podwan/biWheeler/hardware/rfBat/log.md

# 2024.4.7

- 烧录点加丝印 

- 购买0805磁珠

- 5V LDO 原理修正 

- 复位按键换成4脚
