podwan/biWheeler/hardware/encoder/doc/AS5600资料/as5600/as5600/MDK-ARM/as5600/as5600.htm

# Static Call Graph for image as5600\as5600.axf

#<CALLGRAPH># ARM Linker, 5060528: Last Updated: Sun Jan 06 20:27:17 2019

### Maximum Stack Usage = 180 bytes + Unknown(Cycles, Untraceable Function Pointers)

### Call chain for Maximum Stack Depth:

main ⇒ SystemClock_Config ⇒ HAL_RCC_ClockConfig ⇒ HAL_RCC_GetSysClockFreq ⇒ __aeabi_uidivmod

### Mutually Recursive functions

- ADC1_IRQHandler ⇒ ADC1_IRQHandler
- HardFault_Handler ⇒ HardFault_Handler

### Function Pointers

- ADC1_IRQHandler from startup_stm32f030x6.o(.text) referenced from startup_stm32f030x6.o(RESET)
- DMA1_Channel1_IRQHandler from startup_stm32f030x6.o(.text) referenced from startup_stm32f030x6.o(RESET)
- DMA1_Channel2_3_IRQHandler from stm32f0xx_it.o(i.DMA1_Channel2_3_IRQHandler) referenced from startup_stm32f030x6.o(RESET)
- DMA1_Channel4_5_IRQHandler from startup_stm32f030x6.o(.text) referenced from startup_stm32f030x6.o(RESET)
- EXTI0_1_IRQHandler from startup_stm32f030x6.o(.text) referenced from startup_stm32f030x6.o(RESET)
- EXTI2_3_IRQHandler from startup_stm32f030x6.o(.text) referenced from startup_stm32f030x6.o(RESET)
- EXTI4_15_IRQHandler from startup_stm32f030x6.o(.text) referenced from startup_stm32f030x6.o(RESET)
- FLASH_IRQHandler from startup_stm32f030x6.o(.text) referenced from startup_stm32f030x6.o(RESET)
- HardFault_Handler from stm32f0xx_it.o(i.HardFault_Handler) referenced from startup_stm32f030x6.o(RESET)
- I2C1_IRQHandler from startup_stm32f030x6.o(.text) referenced from startup_stm32f030x6.o(RESET)
- NMI_Handler from stm32f0xx_it.o(i.NMI_Handler) referenced from startup_stm32f030x6.o(RESET)
- PendSV_Handler from stm32f0xx_it.o(i.PendSV_Handler) referenced from startup_stm32f030x6.o(RESET)
- RCC_IRQHandler from startup_stm32f030x6.o(.text) referenced from startup_stm32f030x6.o(RESET)
- RTC_IRQHandler from startup_stm32f030x6.o(.text) referenced from startup_stm32f030x6.o(RESET)
- Reset_Handler from startup_stm32f030x6.o(.text) referenced from startup_stm32f030x6.o(RESET)
- SPI1_IRQHandler from startup_stm32f030x6.o(.text) referenced from startup_stm32f030x6.o(RESET)
- SVC_Handler from stm32f0xx_it.o(i.SVC_Handler) referenced from startup_stm32f030x6.o(RESET)
- SysTick_Handler from stm32f0xx_it.o(i.SysTick_Handler) referenced from startup_stm32f030x6.o(RESET)
- SystemInit from system_stm32f0xx.o(i.SystemInit) referenced from startup_stm32f030x6.o(.text)
- TIM14_IRQHandler from startup_stm32f030x6.o(.text) referenced from startup_stm32f030x6.o(RESET)
- TIM16_IRQHandler from startup_stm32f030x6.o(.text) referenced from startup_stm32f030x6.o(RESET)
- TIM17_IRQHandler from startup_stm32f030x6.o(.text) referenced from startup_stm32f030x6.o(RESET)
- TIM1_BRK_UP_TRG_COM_IRQHandler from startup_stm32f030x6.o(.text) referenced from startup_stm32f030x6.o(RESET)
- TIM1_CC_IRQHandler from startup_stm32f030x6.o(.text) referenced from startup_stm32f030x6.o(RESET)
- TIM3_IRQHandler from startup_stm32f030x6.o(.text) referenced from startup_stm32f030x6.o(RESET)
- UART_DMAAbortOnError from stm32f0xx_hal_uart.o(i.UART_DMAAbortOnError) referenced from stm32f0xx_hal_uart.o(i.HAL_UART_IRQHandler)
- USART1_IRQHandler from stm32f0xx_it.o(i.USART1_IRQHandler) referenced from startup_stm32f030x6.o(RESET)
- WWDG_IRQHandler from startup_stm32f030x6.o(.text) referenced from startup_stm32f030x6.o(RESET)
- __main from entry.o(.ARM.Collect$$$$00000000) referenced from startup_stm32f030x6.o(.text)
- fputc from main.o(i.fputc) referenced from printfa.o(i.__0printf)
- main from main.o(i.main) referenced from entry9a.o(.ARM.Collect$$$$0000000B)

### Global Symbols

__main (Thumb, 0 bytes, Stack size unknown bytes, entry.o(.ARM.Collect$$$$00000000))
[Address Reference Count : 1]

- startup_stm32f030x6.o(.text)

_main_stk (Thumb, 0 bytes, Stack size unknown bytes, entry2.o(.ARM.Collect$$$$00000001))

_main_scatterload (Thumb, 0 bytes, Stack size unknown bytes, entry5.o(.ARM.Collect$$$$00000004))

[Calls]

- >> __scatterload

__main_after_scatterload (Thumb, 0 bytes, Stack size unknown bytes, entry5.o(.ARM.Collect$$$$00000004))

[Called By]

- >> __scatterload

_main_clock (Thumb, 0 bytes, Stack size unknown bytes, entry7b.o(.ARM.Collect$$$$00000008))

_main_cpp_init (Thumb, 0 bytes, Stack size unknown bytes, entry8b.o(.ARM.Collect$$$$0000000A))

_main_init (Thumb, 0 bytes, Stack size unknown bytes, entry9a.o(.ARM.Collect$$$$0000000B))

__rt_final_cpp (Thumb, 0 bytes, Stack size unknown bytes, entry10a.o(.ARM.Collect$$$$0000000D))

__rt_final_exit (Thumb, 0 bytes, Stack size unknown bytes, entry11a.o(.ARM.Collect$$$$0000000F))

Reset_Handler (Thumb, 8 bytes, Stack size 0 bytes, startup_stm32f030x6.o(.text))
[Address Reference Count : 1]

- startup_stm32f030x6.o(RESET)

ADC1_IRQHandler (Thumb, 0 bytes, Stack size 0 bytes, startup_stm32f030x6.o(.text))

[Calls]

- >> ADC1_IRQHandler

[Called By]

- >> ADC1_IRQHandler

[Address Reference Count : 1]

- startup_stm32f030x6.o(RESET)

DMA1_Channel1_IRQHandler (Thumb, 0 bytes, Stack size 0 bytes, startup_stm32f030x6.o(.text))
[Address Reference Count : 1]

- startup_stm32f030x6.o(RESET)

DMA1_Channel4_5_IRQHandler (Thumb, 0 bytes, Stack size 0 bytes, startup_stm32f030x6.o(.text))
[Address Reference Count : 1]

- startup_stm32f030x6.o(RESET)

EXTI0_1_IRQHandler (Thumb, 0 bytes, Stack size 0 bytes, startup_stm32f030x6.o(.text))
[Address Reference Count : 1]

- startup_stm32f030x6.o(RESET)

EXTI2_3_IRQHandler (Thumb, 0 bytes, Stack size 0 bytes, startup_stm32f030x6.o(.text))
[Address Reference Count : 1]

- startup_stm32f030x6.o(RESET)

EXTI4_15_IRQHandler (Thumb, 0 bytes, Stack size 0 bytes, startup_stm32f030x6.o(.text))
[Address Reference Count : 1]

- startup_stm32f030x6.o(RESET)

FLASH_IRQHandler (Thumb, 0 bytes, Stack size 0 bytes, startup_stm32f030x6.o(.text))
[Address Reference Count : 1]

- startup_stm32f030x6.o(RESET)

I2C1_IRQHandler (Thumb, 0 bytes, Stack size 0 bytes, startup_stm32f030x6.o(.text))
[Address Reference Count : 1]

- startup_stm32f030x6.o(RESET)

RCC_IRQHandler (Thumb, 0 bytes, Stack size 0 bytes, startup_stm32f030x6.o(.text))
[Address Reference Count : 1]

- startup_stm32f030x6.o(RESET)

RTC_IRQHandler (Thumb, 0 bytes, Stack size 0 bytes, startup_stm32f030x6.o(.text))
[Address Reference Count : 1]

- startup_stm32f030x6.o(RESET)

SPI1_IRQHandler (Thumb, 0 bytes, Stack size 0 bytes, startup_stm32f030x6.o(.text))
[Address Reference Count : 1]

- startup_stm32f030x6.o(RESET)

TIM14_IRQHandler (Thumb, 0 bytes, Stack size 0 bytes, startup_stm32f030x6.o(.text))
[Address Reference Count : 1]

- startup_stm32f030x6.o(RESET)

TIM16_IRQHandler (Thumb, 0 bytes, Stack size 0 bytes, startup_stm32f030x6.o(.text))
[Address Reference Count : 1]

- startup_stm32f030x6.o(RESET)

TIM17_IRQHandler (Thumb, 0 bytes, Stack size 0 bytes, startup_stm32f030x6.o(.text))
[Address Reference Count : 1]

- startup_stm32f030x6.o(RESET)

TIM1_BRK_UP_TRG_COM_IRQHandler (Thumb, 0 bytes, Stack size 0 bytes, startup_stm32f030x6.o(.text))
[Address Reference Count : 1]

- startup_stm32f030x6.o(RESET)

TIM1_CC_IRQHandler (Thumb, 0 bytes, Stack size 0 bytes, startup_stm32f030x6.o(.text))
[Address Reference Count : 1]

- startup_stm32f030x6.o(RESET)

TIM3_IRQHandler (Thumb, 0 bytes, Stack size 0 bytes, startup_stm32f030x6.o(.text))
[Address Reference Count : 1]

- startup_stm32f030x6.o(RESET)

WWDG_IRQHandler (Thumb, 0 bytes, Stack size 0 bytes, startup_stm32f030x6.o(.text))
[Address Reference Count : 1]

- startup_stm32f030x6.o(RESET)

__aeabi_uidiv (Thumb, 0 bytes, Stack size 12 bytes, uidiv.o(.text), UNUSED)

__aeabi_uidivmod (Thumb, 44 bytes, Stack size 12 bytes, uidiv.o(.text))

[Stack]

- Max Depth = 12
- Call Chain = __aeabi_uidivmod

[Called By]

- >> DMA_CalcBaseAndBitshift
- >> HAL_InitTick
- >> HAL_RCC_GetSysClockFreq
- >> UART_SetConfig
- >> _printf_core

__aeabi_llsr (Thumb, 34 bytes, Stack size 8 bytes, llushr.o(.text))

[Stack]

- Max Depth = 8
- Call Chain = __aeabi_llsr

[Called By]

- >> __aeabi_uldivmod
- >> _double_epilogue
- >> __aeabi_d2ulz

_ll_ushift_r (Thumb, 0 bytes, Stack size 8 bytes, llushr.o(.text), UNUSED)

__aeabi_memset (Thumb, 14 bytes, Stack size 0 bytes, memseta.o(.text), UNUSED)

[Called By]

- >> _memset$wrapper
- >> __aeabi_memclr

__aeabi_memset4 (Thumb, 0 bytes, Stack size 0 bytes, memseta.o(.text), UNUSED)

__aeabi_memset8 (Thumb, 0 bytes, Stack size 0 bytes, memseta.o(.text), UNUSED)

__aeabi_memclr (Thumb, 4 bytes, Stack size 0 bytes, memseta.o(.text), UNUSED)

[Calls]

- >> __aeabi_memset

__aeabi_memclr4 (Thumb, 0 bytes, Stack size 0 bytes, memseta.o(.text))

[Called By]

- >> HAL_UART_MspInit
- >> SystemClock_Config
- >> MX_GPIO_Init

__aeabi_memclr8 (Thumb, 0 bytes, Stack size 0 bytes, memseta.o(.text), UNUSED)

_memset$wrapper (Thumb, 18 bytes, Stack size 8 bytes, memseta.o(.text), UNUSED)

[Calls]

- >> __aeabi_memset

__aeabi_dmul (Thumb, 202 bytes, Stack size 72 bytes, dmul.o(.text))

[Stack]

- Max Depth = 128
- Call Chain = __aeabi_dmul ⇒ _double_epilogue ⇒ __aeabi_llsr

[Calls]

- >> _double_epilogue

[Called By]

- >> convertRawAngleToDegrees
- >> _fp_digits

__aeabi_i2d (Thumb, 34 bytes, Stack size 16 bytes, dflti.o(.text))

[Stack]

- Max Depth = 72
- Call Chain = __aeabi_i2d ⇒ _double_epilogue ⇒ __aeabi_llsr

[Calls]

- >> _double_epilogue

[Called By]

- >> convertRawAngleToDegrees

__aeabi_f2d (Thumb, 40 bytes, Stack size 0 bytes, f2d.o(.text))

[Called By]

- >> Programe_Run

__aeabi_d2f (Thumb, 56 bytes, Stack size 8 bytes, d2f.o(.text))

[Stack]

- Max Depth = 8
- Call Chain = __aeabi_d2f

[Calls]

- >> _float_round

[Called By]

- >> convertRawAngleToDegrees

__aeabi_uldivmod (Thumb, 96 bytes, Stack size 48 bytes, uldiv.o(.text), UNUSED)

[Calls]

- >> __aeabi_llsr
- >> __aeabi_llsl

[Called By]

- >> _printf_core
- >> _fp_digits

__I$use$fp (Thumb, 0 bytes, Stack size 0 bytes, iusefp.o(.text), UNUSED)

_float_round (Thumb, 16 bytes, Stack size 0 bytes, fepilogue.o(.text))

[Called By]

- >> __aeabi_d2f

_float_epilogue (Thumb, 114 bytes, Stack size 12 bytes, fepilogue.o(.text), UNUSED)

_double_round (Thumb, 26 bytes, Stack size 8 bytes, depilogue.o(.text))

[Stack]

- Max Depth = 8
- Call Chain = _double_round

[Called By]

- >> _double_epilogue
- >> __aeabi_ddiv
- >> __aeabi_dadd

_double_epilogue (Thumb, 164 bytes, Stack size 48 bytes, depilogue.o(.text))

[Stack]

- Max Depth = 56
- Call Chain = _double_epilogue ⇒ __aeabi_llsr

[Calls]

- >> __aeabi_llsr
- >> __aeabi_llsl
- >> __ARM_clz
- >> _double_round

[Called By]

- >> __aeabi_i2d
- >> __aeabi_dmul
- >> __aeabi_dadd

__aeabi_dadd (Thumb, 328 bytes, Stack size 48 bytes, dadd.o(.text), UNUSED)

[Calls]

- >> __aeabi_lasr
- >> __aeabi_llsl
- >> _double_round
- >> _double_epilogue

[Called By]

- >> __aeabi_drsub
- >> __aeabi_dsub
- >> _fp_digits

__aeabi_dsub (Thumb, 12 bytes, Stack size 8 bytes, dadd.o(.text), UNUSED)

[Calls]

- >> __aeabi_dadd

__aeabi_drsub (Thumb, 12 bytes, Stack size 8 bytes, dadd.o(.text), UNUSED)

[Calls]

- >> __aeabi_dadd

__aeabi_ddiv (Thumb, 234 bytes, Stack size 40 bytes, ddiv.o(.text), UNUSED)

[Calls]

- >> _double_round

[Called By]

- >> _fp_digits

__aeabi_d2ulz (Thumb, 54 bytes, Stack size 8 bytes, dfixul.o(.text), UNUSED)

[Calls]

- >> __aeabi_llsr
- >> __aeabi_llsl

[Called By]

- >> _fp_digits

__aeabi_cdrcmple (Thumb, 38 bytes, Stack size 0 bytes, cdrcmple.o(.text), UNUSED)

[Called By]

- >> _fp_digits

__scatterload (Thumb, 28 bytes, Stack size 0 bytes, init.o(.text))

[Calls]

- >> __main_after_scatterload

[Called By]

- >> _main_scatterload

__scatterload_rt2 (Thumb, 0 bytes, Stack size 0 bytes, init.o(.text), UNUSED)

__aeabi_llsl (Thumb, 32 bytes, Stack size 8 bytes, llshl.o(.text))

[Stack]

- Max Depth = 8
- Call Chain = __aeabi_llsl

[Called By]

- >> __aeabi_uldivmod
- >> _double_epilogue
- >> __aeabi_dadd
- >> __aeabi_d2ulz

_ll_shift_l (Thumb, 0 bytes, Stack size 8 bytes, llshl.o(.text), UNUSED)

__aeabi_lasr (Thumb, 38 bytes, Stack size 8 bytes, llsshr.o(.text), UNUSED)

[Called By]

- >> __aeabi_dadd

_ll_sshift_r (Thumb, 0 bytes, Stack size 8 bytes, llsshr.o(.text), UNUSED)

DMA1_Channel2_3_IRQHandler (Thumb, 10 bytes, Stack size 8 bytes, stm32f0xx_it.o(i.DMA1_Channel2_3_IRQHandler))

[Stack]

- Max Depth = 24
- Call Chain = DMA1_Channel2_3_IRQHandler ⇒ HAL_DMA_IRQHandler

[Calls]

- >> HAL_DMA_IRQHandler

[Address Reference Count : 1]

- startup_stm32f030x6.o(RESET)

Error_Handler (Thumb, 2 bytes, Stack size 0 bytes, main.o(i.Error_Handler))

[Called By]

- >> HAL_UART_MspInit

HAL_DMA_Abort_IT (Thumb, 72 bytes, Stack size 16 bytes, stm32f0xx_hal_dma.o(i.HAL_DMA_Abort_IT))

[Stack]

- Max Depth = 16
- Call Chain = HAL_DMA_Abort_IT

[Called By]

- >> HAL_UART_IRQHandler

HAL_DMA_IRQHandler (Thumb, 156 bytes, Stack size 16 bytes, stm32f0xx_hal_dma.o(i.HAL_DMA_IRQHandler))

[Stack]

- Max Depth = 16
- Call Chain = HAL_DMA_IRQHandler

[Called By]

- >> DMA1_Channel2_3_IRQHandler

HAL_DMA_Init (Thumb, 84 bytes, Stack size 16 bytes, stm32f0xx_hal_dma.o(i.HAL_DMA_Init))

[Stack]

- Max Depth = 36
- Call Chain = HAL_DMA_Init ⇒ DMA_CalcBaseAndBitshift ⇒ __aeabi_uidivmod

[Calls]

- >> DMA_CalcBaseAndBitshift

[Called By]

- >> HAL_UART_MspInit

HAL_Delay (Thumb, 28 bytes, Stack size 16 bytes, stm32f0xx_hal.o(i.HAL_Delay))

[Stack]

- Max Depth = 16
- Call Chain = HAL_Delay

[Calls]

- >> HAL_GetTick

[Called By]

- >> main

HAL_GPIO_Init (Thumb, 302 bytes, Stack size 24 bytes, stm32f0xx_hal_gpio.o(i.HAL_GPIO_Init))

[Stack]

- Max Depth = 24
- Call Chain = HAL_GPIO_Init

[Called By]

- >> HAL_UART_MspInit
- >> MX_GPIO_Init

HAL_GPIO_WritePin (Thumb, 12 bytes, Stack size 0 bytes, stm32f0xx_hal_gpio.o(i.HAL_GPIO_WritePin))

[Called By]

- >> MX_GPIO_Init

HAL_GetTick (Thumb, 6 bytes, Stack size 0 bytes, stm32f0xx_hal.o(i.HAL_GetTick))

[Called By]

- >> HAL_UART_Transmit
- >> HAL_RCC_OscConfig
- >> HAL_RCC_ClockConfig
- >> HAL_RCCEx_PeriphCLKConfig
- >> HAL_Delay
- >> UART_WaitOnFlagUntilTimeout

HAL_IncTick (Thumb, 10 bytes, Stack size 0 bytes, stm32f0xx_hal.o(i.HAL_IncTick))

[Called By]

- >> SysTick_Handler

HAL_Init (Thumb, 26 bytes, Stack size 8 bytes, stm32f0xx_hal.o(i.HAL_Init))

[Stack]

- Max Depth = 28
- Call Chain = HAL_Init ⇒ HAL_InitTick ⇒ __aeabi_uidivmod

[Calls]

- >> HAL_MspInit
- >> HAL_InitTick

[Called By]

- >> main

HAL_InitTick (Thumb, 34 bytes, Stack size 8 bytes, stm32f0xx_hal.o(i.HAL_InitTick))

[Stack]

- Max Depth = 20
- Call Chain = HAL_InitTick ⇒ __aeabi_uidivmod

[Calls]

- >> HAL_NVIC_SetPriority
- >> __aeabi_uidivmod
- >> HAL_SYSTICK_Config
- >> HAL_RCC_GetHCLKFreq

[Called By]

- >> HAL_RCC_ClockConfig
- >> HAL_Init

HAL_MspInit (Thumb, 34 bytes, Stack size 8 bytes, stm32f0xx_hal_msp.o(i.HAL_MspInit))

[Stack]

- Max Depth = 8
- Call Chain = HAL_MspInit

[Called By]

- >> HAL_Init

HAL_NVIC_EnableIRQ (Thumb, 14 bytes, Stack size 0 bytes, stm32f0xx_hal_cortex.o(i.HAL_NVIC_EnableIRQ))

[Called By]

- >> HAL_UART_MspInit
- >> main

HAL_NVIC_SetPriority (Thumb, 8 bytes, Stack size 8 bytes, stm32f0xx_hal_cortex.o(i.HAL_NVIC_SetPriority))

[Stack]

- Max Depth = 8
- Call Chain = HAL_NVIC_SetPriority

[Calls]

- >> NVIC_SetPriority

[Called By]

- >> HAL_UART_MspInit
- >> main
- >> HAL_InitTick

HAL_RCCEx_PeriphCLKConfig (Thumb, 218 bytes, Stack size 24 bytes, stm32f0xx_hal_rcc_ex.o(i.HAL_RCCEx_PeriphCLKConfig))

[Stack]

- Max Depth = 24
- Call Chain = HAL_RCCEx_PeriphCLKConfig

[Calls]

- >> HAL_GetTick

[Called By]

- >> SystemClock_Config

HAL_RCC_ClockConfig (Thumb, 280 bytes, Stack size 24 bytes, stm32f0xx_hal_rcc.o(i.HAL_RCC_ClockConfig))

[Stack]

- Max Depth = 76
- Call Chain = HAL_RCC_ClockConfig ⇒ HAL_RCC_GetSysClockFreq ⇒ __aeabi_uidivmod

[Calls]

- >> HAL_InitTick
- >> HAL_RCC_GetSysClockFreq
- >> HAL_GetTick

[Called By]

- >> SystemClock_Config

HAL_RCC_GetHCLKFreq (Thumb, 6 bytes, Stack size 0 bytes, stm32f0xx_hal_rcc.o(i.HAL_RCC_GetHCLKFreq))

[Called By]

- >> HAL_InitTick

HAL_RCC_GetPCLK1Freq (Thumb, 20 bytes, Stack size 0 bytes, stm32f0xx_hal_rcc.o(i.HAL_RCC_GetPCLK1Freq))

[Called By]

- >> UART_SetConfig

HAL_RCC_GetSysClockFreq (Thumb, 76 bytes, Stack size 40 bytes, stm32f0xx_hal_rcc.o(i.HAL_RCC_GetSysClockFreq))

[Stack]

- Max Depth = 52
- Call Chain = HAL_RCC_GetSysClockFreq ⇒ __aeabi_uidivmod

[Calls]

- >> __aeabi_uidivmod

[Called By]

- >> HAL_RCC_ClockConfig
- >> UART_SetConfig

HAL_RCC_OscConfig (Thumb, 840 bytes, Stack size 32 bytes, stm32f0xx_hal_rcc.o(i.HAL_RCC_OscConfig))

[Stack]

- Max Depth = 32
- Call Chain = HAL_RCC_OscConfig

[Calls]

- >> HAL_GetTick

[Called By]

- >> SystemClock_Config

HAL_SYSTICK_Config (Thumb, 38 bytes, Stack size 8 bytes, stm32f0xx_hal_cortex.o(i.HAL_SYSTICK_Config))

[Stack]

- Max Depth = 8
- Call Chain = HAL_SYSTICK_Config

[Calls]

- >> NVIC_SetPriority

[Called By]

- >> HAL_InitTick

HAL_UART_ErrorCallback (Thumb, 2 bytes, Stack size 0 bytes, stm32f0xx_hal_uart.o(i.HAL_UART_ErrorCallback))

[Called By]

- >> UART_DMAAbortOnError
- >> HAL_UART_IRQHandler

HAL_UART_IRQHandler (Thumb, 272 bytes, Stack size 24 bytes, stm32f0xx_hal_uart.o(i.HAL_UART_IRQHandler))

[Stack]

- Max Depth = 40
- Call Chain = HAL_UART_IRQHandler ⇒ HAL_DMA_Abort_IT

[Calls]

- >> UART_EndRxTransfer
- >> HAL_UART_ErrorCallback
- >> HAL_DMA_Abort_IT
- >> UART_Transmit_IT
- >> UART_Receive_IT
- >> UART_EndTransmit_IT

[Called By]

- >> USART1_IRQHandler

HAL_UART_Init (Thumb, 108 bytes, Stack size 16 bytes, stm32f0xx_hal_uart.o(i.HAL_UART_Init))

[Stack]

- Max Depth = 92
- Call Chain = HAL_UART_Init ⇒ HAL_UART_MspInit ⇒ HAL_DMA_Init ⇒ DMA_CalcBaseAndBitshift ⇒ __aeabi_uidivmod

[Calls]

- >> HAL_UART_MspInit
- >> UART_SetConfig
- >> UART_CheckIdleState
- >> UART_AdvFeatureConfig

[Called By]

- >> MX_USART1_UART_Init

HAL_UART_MspInit (Thumb, 146 bytes, Stack size 40 bytes, stm32f0xx_hal_msp.o(i.HAL_UART_MspInit))

[Stack]

- Max Depth = 76
- Call Chain = HAL_UART_MspInit ⇒ HAL_DMA_Init ⇒ DMA_CalcBaseAndBitshift ⇒ __aeabi_uidivmod

[Calls]

- >> HAL_DMA_Init
- >> HAL_NVIC_SetPriority
- >> HAL_NVIC_EnableIRQ
- >> HAL_GPIO_Init
- >> Error_Handler
- >> __aeabi_memclr4

[Called By]

- >> HAL_UART_Init

HAL_UART_Receive_IT (Thumb, 132 bytes, Stack size 16 bytes, stm32f0xx_hal_uart.o(i.HAL_UART_Receive_IT))

[Stack]

- Max Depth = 16
- Call Chain = HAL_UART_Receive_IT

[Called By]

- >> main

HAL_UART_RxCpltCallback (Thumb, 2 bytes, Stack size 0 bytes, stm32f0xx_hal_uart.o(i.HAL_UART_RxCpltCallback))

[Called By]

- >> UART_Receive_IT

HAL_UART_Transmit (Thumb, 200 bytes, Stack size 48 bytes, stm32f0xx_hal_uart.o(i.HAL_UART_Transmit))

[Stack]

- Max Depth = 88
- Call Chain = HAL_UART_Transmit ⇒ UART_WaitOnFlagUntilTimeout

[Calls]

- >> HAL_GetTick
- >> UART_WaitOnFlagUntilTimeout

[Called By]

- >> fputc

HAL_UART_TxCpltCallback (Thumb, 2 bytes, Stack size 0 bytes, stm32f0xx_hal_uart.o(i.HAL_UART_TxCpltCallback))

[Called By]

- >> UART_EndTransmit_IT

HardFault_Handler (Thumb, 2 bytes, Stack size 0 bytes, stm32f0xx_it.o(i.HardFault_Handler))

[Calls]

- >> HardFault_Handler

[Called By]

- >> HardFault_Handler

[Address Reference Count : 1]

- startup_stm32f030x6.o(RESET)

NMI_Handler (Thumb, 2 bytes, Stack size 0 bytes, stm32f0xx_it.o(i.NMI_Handler))
[Address Reference Count : 1]

- startup_stm32f030x6.o(RESET)

PendSV_Handler (Thumb, 2 bytes, Stack size 0 bytes, stm32f0xx_it.o(i.PendSV_Handler))
[Address Reference Count : 1]

- startup_stm32f030x6.o(RESET)

Programe_Run (Thumb, 56 bytes, Stack size 8 bytes, as5600.o(i.Programe_Run))

[Stack]

- Max Depth = 144
- Call Chain = Programe_Run ⇒ convertRawAngleToDegrees ⇒ __aeabi_dmul ⇒ _double_epilogue ⇒ __aeabi_llsr

[Calls]

- >> __aeabi_f2d
- >> getRawAngle
- >> detectMagnet
- >> convertRawAngleToDegrees
- >> __2printf

[Called By]

- >> main

SVC_Handler (Thumb, 2 bytes, Stack size 0 bytes, stm32f0xx_it.o(i.SVC_Handler))
[Address Reference Count : 1]

- startup_stm32f030x6.o(RESET)

Sim_I2C1_ReceiveByte (Thumb, 88 bytes, Stack size 16 bytes, as5600.o(i.Sim_I2C1_ReceiveByte))

[Stack]

- Max Depth = 16
- Call Chain = Sim_I2C1_ReceiveByte

[Calls]

- >> Sim_I2C1_SendNACK

[Called By]

- >> Sim_I2C_Read8

Sim_I2C1_ReceiveByte_WithACK (Thumb, 88 bytes, Stack size 16 bytes, as5600.o(i.Sim_I2C1_ReceiveByte_WithACK))

[Stack]

- Max Depth = 16
- Call Chain = Sim_I2C1_ReceiveByte_WithACK

[Calls]

- >> Sim_I2C1_SendACK

[Called By]

- >> Sim_I2C_Read8

Sim_I2C1_START (Thumb, 78 bytes, Stack size 0 bytes, as5600.o(i.Sim_I2C1_START))

[Called By]

- >> Sim_I2C_Read8

Sim_I2C1_STOP (Thumb, 70 bytes, Stack size 0 bytes, as5600.o(i.Sim_I2C1_STOP))

[Called By]

- >> Sim_I2C_Read8
- >> Sim_I2C1_Wait_Ack

Sim_I2C1_SendACK (Thumb, 76 bytes, Stack size 0 bytes, as5600.o(i.Sim_I2C1_SendACK))

[Called By]

- >> Sim_I2C1_ReceiveByte_WithACK

Sim_I2C1_SendByte (Thumb, 102 bytes, Stack size 20 bytes, as5600.o(i.Sim_I2C1_SendByte))

[Stack]

- Max Depth = 20
- Call Chain = Sim_I2C1_SendByte

[Called By]

- >> Sim_I2C_Read8

Sim_I2C1_SendNACK (Thumb, 76 bytes, Stack size 0 bytes, as5600.o(i.Sim_I2C1_SendNACK))

[Called By]

- >> Sim_I2C1_ReceiveByte

Sim_I2C1_Wait_Ack (Thumb, 100 bytes, Stack size 12 bytes, as5600.o(i.Sim_I2C1_Wait_Ack))

[Stack]

- Max Depth = 12
- Call Chain = Sim_I2C1_Wait_Ack

[Calls]

- >> Sim_I2C1_STOP

[Called By]

- >> Sim_I2C_Read8

Sim_I2C_Read8 (Thumb, 88 bytes, Stack size 20 bytes, as5600.o(i.Sim_I2C_Read8))

[Stack]

- Max Depth = 40
- Call Chain = Sim_I2C_Read8 ⇒ Sim_I2C1_SendByte

[Calls]

- >> Sim_I2C1_Wait_Ack
- >> Sim_I2C1_SendByte
- >> Sim_I2C1_STOP
- >> Sim_I2C1_START
- >> Sim_I2C1_ReceiveByte_WithACK
- >> Sim_I2C1_ReceiveByte

[Called By]

- >> readOneByte

SysTick_Handler (Thumb, 8 bytes, Stack size 8 bytes, stm32f0xx_it.o(i.SysTick_Handler))

[Stack]

- Max Depth = 8
- Call Chain = SysTick_Handler

[Calls]

- >> HAL_IncTick

[Address Reference Count : 1]

- startup_stm32f030x6.o(RESET)

SystemClock_Config (Thumb, 92 bytes, Stack size 96 bytes, main.o(i.SystemClock_Config))

[Stack]

- Max Depth = 172
- Call Chain = SystemClock_Config ⇒ HAL_RCC_ClockConfig ⇒ HAL_RCC_GetSysClockFreq ⇒ __aeabi_uidivmod

[Calls]

- >> HAL_RCC_OscConfig
- >> HAL_RCC_ClockConfig
- >> HAL_RCCEx_PeriphCLKConfig
- >> __aeabi_memclr4

[Called By]

- >> main

SystemInit (Thumb, 78 bytes, Stack size 0 bytes, system_stm32f0xx.o(i.SystemInit))
[Address Reference Count : 1]

- startup_stm32f030x6.o(.text)

UART_AdvFeatureConfig (Thumb, 202 bytes, Stack size 8 bytes, stm32f0xx_hal_uart.o(i.UART_AdvFeatureConfig))

[Stack]

- Max Depth = 8
- Call Chain = UART_AdvFeatureConfig

[Called By]

- >> HAL_UART_Init

UART_CheckIdleState (Thumb, 18 bytes, Stack size 0 bytes, stm32f0xx_hal_uart.o(i.UART_CheckIdleState))

[Called By]

- >> HAL_UART_Init

UART_EndTransmit_IT (Thumb, 26 bytes, Stack size 8 bytes, stm32f0xx_hal_uart.o(i.UART_EndTransmit_IT))

[Stack]

- Max Depth = 8
- Call Chain = UART_EndTransmit_IT

[Calls]

- >> HAL_UART_TxCpltCallback

[Called By]

- >> HAL_UART_IRQHandler

UART_Receive_IT (Thumb, 122 bytes, Stack size 16 bytes, stm32f0xx_hal_uart.o(i.UART_Receive_IT))

[Stack]

- Max Depth = 16
- Call Chain = UART_Receive_IT

[Calls]

- >> HAL_UART_RxCpltCallback

[Called By]

- >> HAL_UART_IRQHandler

UART_SetConfig (Thumb, 258 bytes, Stack size 24 bytes, stm32f0xx_hal_uart.o(i.UART_SetConfig))

[Stack]

- Max Depth = 76
- Call Chain = UART_SetConfig ⇒ HAL_RCC_GetSysClockFreq ⇒ __aeabi_uidivmod

[Calls]

- >> __aeabi_uidivmod
- >> HAL_RCC_GetSysClockFreq
- >> HAL_RCC_GetPCLK1Freq

[Called By]

- >> HAL_UART_Init

UART_Transmit_IT (Thumb, 102 bytes, Stack size 0 bytes, stm32f0xx_hal_uart.o(i.UART_Transmit_IT))

[Called By]

- >> HAL_UART_IRQHandler

UART_WaitOnFlagUntilTimeout (Thumb, 98 bytes, Stack size 40 bytes, stm32f0xx_hal_uart.o(i.UART_WaitOnFlagUntilTimeout))

[Stack]

- Max Depth = 40
- Call Chain = UART_WaitOnFlagUntilTimeout

[Calls]

- >> HAL_GetTick

[Called By]

- >> HAL_UART_Transmit

USART1_IRQHandler (Thumb, 10 bytes, Stack size 8 bytes, stm32f0xx_it.o(i.USART1_IRQHandler))

[Stack]

- Max Depth = 48
- Call Chain = USART1_IRQHandler ⇒ HAL_UART_IRQHandler ⇒ HAL_DMA_Abort_IT

[Calls]

- >> HAL_UART_IRQHandler

[Address Reference Count : 1]

- startup_stm32f030x6.o(RESET)

Uart_RxOvertimeEnable (Thumb, 22 bytes, Stack size 0 bytes, main.o(i.Uart_RxOvertimeEnable))

[Called By]

- >> main

__0printf (Thumb, 24 bytes, Stack size 24 bytes, printfa.o(i.__0printf), UNUSED)

[Calls]

- >> _printf_core

__1printf (Thumb, 0 bytes, Stack size 24 bytes, printfa.o(i.__0printf), UNUSED)

__2printf (Thumb, 0 bytes, Stack size 24 bytes, printfa.o(i.__0printf))

[Stack]

- Max Depth = 24
- Call Chain = __2printf

[Called By]

- >> Programe_Run

__c89printf (Thumb, 0 bytes, Stack size 24 bytes, printfa.o(i.__0printf), UNUSED)

printf (Thumb, 0 bytes, Stack size 24 bytes, printfa.o(i.__0printf), UNUSED)

__ARM_clz (Thumb, 46 bytes, Stack size 0 bytes, depilogue.o(i.__ARM_clz))

[Called By]

- >> _double_epilogue

__scatterload_copy (Thumb, 14 bytes, Stack size unknown bytes, handlers.o(i.__scatterload_copy), UNUSED)

__scatterload_null (Thumb, 2 bytes, Stack size unknown bytes, handlers.o(i.__scatterload_null), UNUSED)

__scatterload_zeroinit (Thumb, 14 bytes, Stack size unknown bytes, handlers.o(i.__scatterload_zeroinit), UNUSED)

convertRawAngleToDegrees (Thumb, 20 bytes, Stack size 8 bytes, as5600.o(i.convertRawAngleToDegrees))

[Stack]

- Max Depth = 136
- Call Chain = convertRawAngleToDegrees ⇒ __aeabi_dmul ⇒ _double_epilogue ⇒ __aeabi_llsr

[Calls]

- >> __aeabi_i2d
- >> __aeabi_dmul
- >> __aeabi_d2f

[Called By]

- >> Programe_Run

detectMagnet (Thumb, 20 bytes, Stack size 8 bytes, as5600.o(i.detectMagnet))

[Stack]

- Max Depth = 56
- Call Chain = detectMagnet ⇒ readOneByte ⇒ Sim_I2C_Read8 ⇒ Sim_I2C1_SendByte

[Calls]

- >> readOneByte

[Called By]

- >> Programe_Run

fputc (Thumb, 18 bytes, Stack size 16 bytes, main.o(i.fputc))

[Stack]

- Max Depth = 104
- Call Chain = fputc ⇒ HAL_UART_Transmit ⇒ UART_WaitOnFlagUntilTimeout

[Calls]

- >> HAL_UART_Transmit

[Address Reference Count : 1]

- printfa.o(i.__0printf)

getRawAngle (Thumb, 14 bytes, Stack size 4 bytes, as5600.o(i.getRawAngle))

[Stack]

- Max Depth = 64
- Call Chain = getRawAngle ⇒ readTwoBytes ⇒ readOneByte ⇒ Sim_I2C_Read8 ⇒ Sim_I2C1_SendByte

[Calls]

- >> readTwoBytes

[Called By]

- >> Programe_Run

main (Thumb, 80 bytes, Stack size 8 bytes, main.o(i.main))

[Stack]

- Max Depth = 180
- Call Chain = main ⇒ SystemClock_Config ⇒ HAL_RCC_ClockConfig ⇒ HAL_RCC_GetSysClockFreq ⇒ __aeabi_uidivmod

[Calls]

- >> HAL_UART_Receive_IT
- >> HAL_NVIC_SetPriority
- >> HAL_NVIC_EnableIRQ
- >> HAL_Init
- >> Uart_RxOvertimeEnable
- >> SystemClock_Config
- >> MX_USART1_UART_Init
- >> MX_GPIO_Init
- >> HAL_Delay
- >> Programe_Run

[Address Reference Count : 1]

- entry9a.o(.ARM.Collect$$$$0000000B)

readOneByte (Thumb, 34 bytes, Stack size 8 bytes, as5600.o(i.readOneByte))

[Stack]

- Max Depth = 48
- Call Chain = readOneByte ⇒ Sim_I2C_Read8 ⇒ Sim_I2C1_SendByte

[Calls]

- >> Sim_I2C_Read8

[Called By]

- >> readTwoBytes
- >> detectMagnet

readTwoBytes (Thumb, 24 bytes, Stack size 12 bytes, as5600.o(i.readTwoBytes))

[Stack]

- Max Depth = 60
- Call Chain = readTwoBytes ⇒ readOneByte ⇒ Sim_I2C_Read8 ⇒ Sim_I2C1_SendByte

[Calls]

- >> readOneByte

[Called By]

- >> getRawAngle

### Local Symbols

MX_GPIO_Init (Thumb, 86 bytes, Stack size 40 bytes, main.o(i.MX_GPIO_Init))

[Stack]

- Max Depth = 64
- Call Chain = MX_GPIO_Init ⇒ HAL_GPIO_Init

[Calls]

- >> HAL_GPIO_WritePin
- >> HAL_GPIO_Init
- >> __aeabi_memclr4

[Called By]

- >> main

MX_USART1_UART_Init (Thumb, 40 bytes, Stack size 8 bytes, main.o(i.MX_USART1_UART_Init))

[Stack]

- Max Depth = 100
- Call Chain = MX_USART1_UART_Init ⇒ HAL_UART_Init ⇒ HAL_UART_MspInit ⇒ HAL_DMA_Init ⇒ DMA_CalcBaseAndBitshift ⇒ __aeabi_uidivmod

[Calls]

- >> HAL_UART_Init

[Called By]

- >> main

UART_DMAAbortOnError (Thumb, 20 bytes, Stack size 8 bytes, stm32f0xx_hal_uart.o(i.UART_DMAAbortOnError))

[Stack]

- Max Depth = 8
- Call Chain = UART_DMAAbortOnError

[Calls]

- >> HAL_UART_ErrorCallback

[Address Reference Count : 1]

- stm32f0xx_hal_uart.o(i.HAL_UART_IRQHandler)

UART_EndRxTransfer (Thumb, 30 bytes, Stack size 0 bytes, stm32f0xx_hal_uart.o(i.UART_EndRxTransfer))

[Called By]

- >> HAL_UART_IRQHandler

DMA_CalcBaseAndBitshift (Thumb, 26 bytes, Stack size 8 bytes, stm32f0xx_hal_dma.o(i.DMA_CalcBaseAndBitshift))

[Stack]

- Max Depth = 20
- Call Chain = DMA_CalcBaseAndBitshift ⇒ __aeabi_uidivmod

[Calls]

- >> __aeabi_uidivmod

[Called By]

- >> HAL_DMA_Init

NVIC_SetPriority (Thumb, 60 bytes, Stack size 0 bytes, stm32f0xx_hal_cortex.o(i.NVIC_SetPriority))

[Called By]

- >> HAL_NVIC_SetPriority
- >> HAL_SYSTICK_Config

_fp_digits (Thumb, 344 bytes, Stack size 64 bytes, printfa.o(i._fp_digits), UNUSED)

[Calls]

- >> __aeabi_dmul
- >> __aeabi_uldivmod
- >> __aeabi_ddiv
- >> __aeabi_dadd
- >> __aeabi_d2ulz
- >> __aeabi_cdrcmple

[Called By]

- >> _printf_core

_printf_core (Thumb, 1754 bytes, Stack size 128 bytes, printfa.o(i._printf_core), UNUSED)

[Calls]

- >> __aeabi_uidivmod
- >> __aeabi_uldivmod
- >> _printf_pre_padding
- >> _printf_post_padding
- >> _fp_digits

[Called By]

- >> __0printf

_printf_post_padding (Thumb, 32 bytes, Stack size 24 bytes, printfa.o(i._printf_post_padding), UNUSED)

[Called By]

- >> _printf_core

_printf_pre_padding (Thumb, 44 bytes, Stack size 40 bytes, printfa.o(i._printf_pre_padding), UNUSED)

[Called By]

- >> _printf_core

### Undefined Global Symbols
