podwan/biWheeler/reference/SimpleFOCMini-main/BOM_simplefocmini_2024-04-26.csv

ID | Name | Designator | Footprint | Quantity | Manufacturer Part | Manufacturer | Supplier | Supplier Part | Price
1 | 19-213/Y2C-CQ2R2L/3T(CY) | LED1 | LED0603-R-RD | 1 | 19-213/Y2C-CQ2R2L/3T(CY) | EVERLIGHT | LCSC | C72038 | 0.019
2 | 1kΩ | R5 | R0603 | 1 | 0603WAF4701T5E | UniOhm | LCSC | C23162 | 0.001
3 | 100uF | C3 | CAP-SMD_BD6.3-L6.6-W6.6-FD | 1 | VT1V101M-CRE77 | Vertical Technology | LCSC | C294520 | 0.032
4 | 10kΩ | R1,R2,R3,R4 | R0603 | 4 | 0603WAF4701T5E | UniOhm | LCSC | C23162 | 0.001
5 | 100nF | C1,C2 | C0603 | 2 | CL10B104KB8NNNC | SAMSUNG | LCSC | C1591 | 0.002
6 | 470nF | C4 | C0603 | 1 | CC0603ZRY5V6BB474 | YAGEO | LCSC | C327269 | 0.008
7 | DRV8313PWPR | U1 | HTSSOP-28_L9.8-W4.5-P0.65-LS6.6-BL-EP | 1 | DRV8313PWPR | Texas Instruments | LCSC | C92482 | 2.189
