podwan/biWheeler/reference/Micro-Wheeled_leg-Robot-master/1.RobotModel/Parts-Purchased/BOM.xlsx

Part Name | Recommended Purchase Link | Specifications | Quantity
Joint Actuator | https://item.taobao.com/item.htm?priceTId=2147818c17214662551577531edc58&id=624005504026&ns=1&abbucket=16 | 黑色 STS3032/360° | 2
Wheel Motor | https://item.taobao.com/item.htm?spm=a1z09.2.0.0.6f8c2e8daIyqdB&id=556445606114&_u=k2st8hc2dcef | 零售 | 2
Magnet | https://item.taobao.com/item.htm?id=677927264803&_u=q2st8hc2ca1c&sku_properties=-3:-5 | 直径4mm,厚度1mm | 2
Battery | https://item.taobao.com/item.htm?id=527326501663&_u=k2st8hc287ca&sku_properties=31309:32595472760 | 1100mah | 1
Charger | https://item.taobao.com/item.htm?id=728228890176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 | 平衡锂电充电器 | 1
GB Screws | https://detail.tmall.com/item.htm?id=529656697168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 | M2*4 M2*6 M2.5*5 M3*6 | 20 of each.
GB Nuts | https://detail.tmall.com/item.htm?id=39178267251&rn=b5d916a495226c131bbab29d02221680&abbucket=12 | M2 | 2
Other Screws | https://item.taobao.com/item.htm?spm=a1z09.2.0.0.6f8c2e8daIyqdB&id=538025764032&_u=k2st8hc217d7 | M2.3-0.4*15 | 2
Column_3mm | https://item.taobao.com/item.htm?spm=a1z09.2.0.0.6f8c2e8daIyqdB&id=647328388853&_u=k2st8hc22a77 | M2 x 长3 x 宽3 （贯通牙） | 4
M2x6_BigHead | https://detail.tmall.com/item.htm?id=722946822369&spm=a1z09.2.0.0.6f8c2e8daIyqdB&_u=k2st8hc21ee3 | M2*6 | 4
bearing3-6-2 | https://detail.tmall.com/item.htm?id=611796709407&spm=a1z09.2.0.0.6f8c2e8daIyqdB&_u=k2st8hc2e6c7 | 3*6*2 | 4 | s
bearing4-7-2.5 | https://detail.tmall.com/item.htm?id=611796709407&_u=k2st8hc2e6c7&skuId=4777422306653 | 4*7*2.5 | 4
Pin4-12 | https://detail.tmall.com/item.htm?id=718672136863&spm=a1z09.2.0.0.6f8c2e8daIyqdB&_u=k2st8hc2ae2e | 4X12 | 2
Tire | https://item.taobao.com/item.htm?spm=a1z09.2.0.0.6f8c2e8daIyqdB&id=669383925819&_u=k2st8hc26fde | 直径25宽10mm黑色 | 2
Column_1 | https://detail.tmall.com/item.htm?priceTId=2147804217214673637194390e8199&id=631585716430&xxc=ad_ztc | M2*25+3 | 2
Column_2 | https://detail.tmall.com/item.htm?id=618581380263&spm=a1z09.2.0.0.6f8c2e8daIyqdB&_u=k2st8hc22f44 | M2*8-D3.5MM | 4
Column_3 | https://detail.tmall.com/item.htm?id=19634185206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 | M2*8+3 | 3
