podwan/biWheeler/reference/Micro-Wheeled_leg-Robot-master/2.Hardware/2.EncoderPCB/BOM_PCB_Encoder.csv

ID | Name | Designator | Footprint | Quantity | Manufacturer Part | Manufacturer | Supplier | Supplier Part | Price
1 | GH1.25_4P | J2 | GH1.25_4P_卧贴 | 1 |  | Changjiang Connectors | LCSC | CC225131
2 | 100nf | C1 | C0603 | 1
3 | 1uf | C2 | C0603 | 1
4 | 4.7K | R1,R2 | R0603 | 2
5 | AS5600-ASOM | U1 | SOIC-8_L5.0-W4.0-P1.27-LS6.0-BL | 1 | AS5600-ASOM | Ams | LCSC | C79815 | 8.32
