podwan/biWheeler/reference/Micro-Wheeled_leg-Robot-master/2.Hardware/3.IMUPCB/BOM_PCB_IMU.csv

ID | Name | Designator | Footprint | Quantity | Manufacturer Part | Manufacturer | Supplier | Supplier Part | Price
1 | MPU6050 | P2 | MPU6050 | 1
2 | GH1.25_4P | J2,J1 | GH1.25_4P_卧贴 | 2 |  | Changjiang Connectors | LCSC | CC225131
