podwan/biWheeler/reference/BOM/StackForce双足轮BOM.xlsx

StackForce 双足轮机器人BOM
电子配件
商品简称 | 数量 | 单位 | 规格 | 备注 | 型号
StackForce主控板 | 1 | 块 | StackForce | 购买链接 (https://item.taobao.com/item.htm?spm=a1z10.1-c.w137712-25161502000.3.64eb1bc5SgOITv&id=760739215808)
StackForce 5A小功率驱动板 | 1 | 块 | StackForce | 购买链接 (https://item.taobao.com/item.htm?spm=a1z10.1-c.w137712-25161502000.8.64eb1bc5SgOITv&id=760899823703)
StackForce 舵机板 | 1 | 块 | StackForce | 购买链接 (https://item.taobao.com/item.htm?spm=a1z10.1-c.w137712-25161502000.5.64eb1bc5SgOITv&id=760685702879)
磁编码器 | 2 | 块 | StackForce | 购买链接 (https://item.taobao.com/item.htm?spm=a1z10.1-c.w4004-25161773008.8.64eb1bc5SgOITv&id=760692990504) | MT6701
电机 | 2 | 个 |  |  | 2208
舵机 | 4 | 个 |  |  | DS041MG
遥控器 | 1 | 个 |  |  | MC6C-MINI
接收器 | 1 | 个 |  |  | MC7RBv2
电池 | 1 | 个 | 厚19，宽34，长42 |  | 12V聚合物电池
端头 | 2 | 个 |  | 电机端头 | MR30-U型
编码器线 | 2 | 组 |  | 编码器用 | SH1.0-5P
杜邦线 | 1 | 组 |  | 接收机用 | 3P（母对母）
材料配件
商品简称 | 数量 | 单位 | 规格 | 备注 | 型号
防松螺母 | 4 | 颗 | M3 |  | GB889.1-86
螺母 | 4 | 颗 | M3 |  | DIN934
尼龙柱 | 4 | 根 | 5*3.2*9 |  | ABS
垫片 | 4 | 片 | M3 |  | 304国标
磁铁 | 2 | 颗 | 6*2.5 |  | 径向磁铁
圆头螺丝 | 24 | 颗 | M2*4 |  | GB/T845
圆头螺丝 | 12 | 颗 | M2*10 |  | GB/T845
圆头螺丝 | 4 | 颗 | M3*6 |  | GB/T845
圆头螺丝 | 4 | 颗 | M3*8 |  | GB/T845
圆头螺丝 | 4 | 颗 | M3*16 |  | GB/T845
圆头螺丝 | 4 | 颗 | M4*16 |  | GB/T845
自攻螺丝 | 16 | 颗 | M2*6 |  | GB/T845
平头螺丝 | 22 | 颗 | M2*6 |  | 304国标
平头螺丝 | 16 | 颗 | M3*6 |  | 304国标
螺柱 | 4 | 颗 | M3*7+4 |  | 铜国标/GB
轴承 | 4 | 块 | 外27，内20，厚4 |  | 6704ZZ
轴承 | 6 | 块 | 外18，内12，厚4 |  | 6701ZZ
结构件
商品简称 | 数量 |  |  | 单位
3D打印件 | 25 |  |  | 件
6030-6085轮胎 | 2 |  |  | 个
