podwan/biWheeler/reference/Micro-Wheeled_leg-Robot-master/2.Hardware/4.ServoDebugPCB/BOM_ServoDebug.csv

ID | Name | Designator | Footprint | Quantity | Manufacturer Part | Manufacturer | Supplier | Supplier Part | Price
1 | HDR-F-2.54_2x4 | H1 | HDR-F-2.54_2X4 | 1 |  |  | LCSC | C239344 | 1.0759
2 | 0.1uF | C1,C2 | C0805 | 2 | CC0805KRX7R9BB104 | YAGEO | LCSC | C49678 | 0.0276
3 | WJ126V-5.0-2P | P3 | CONN-TH_WJ126V-5.0-2P | 1 | WJ126V-5.0-2P | ReliaPro | LCSC | C8404 | 0.4358
4 | SS8550 | Q1 | SOT-23_L2.9-W1.3-P0.95-LS2.4-BR | 1 | SS8550 | Slkor(SLKORMICRO Elec.) | LCSC | C444726 | 0.0637
5 | 10k | R1,R2,R3,R4 | R0805 | 4 | 0805W8F1002T5E | UniOhm | LCSC | C17414 | 0.0109
6 | 10k | R5 | R0805 | 1 | 0805W8F2002T5E | UniOhm | LCSC | C4328 | 0.0109
7 | SN74LVC1G126DBVR | U2 | SOT-23-5_L3.0-W1.7-P0.95-LS2.8-BR | 1 | SN74LVC1G125DBVR | TI | LCSC | C23654 | 0.4221
8 | SN74LVC1G125DBVR | U3 | SOT-23-5_L3.0-W1.7-P0.95-LS2.8-BR | 1 | SN74LVC1G125DBVR | TI | LCSC | C23654 | 0.4221
9 | 5264-3A | H2 | 5264-3A | 1 |  |  | LCSC | C146133 | 0.0866
