podwan/biWheeler/hardware/encoder/encoder_edge-Sketch.dxf

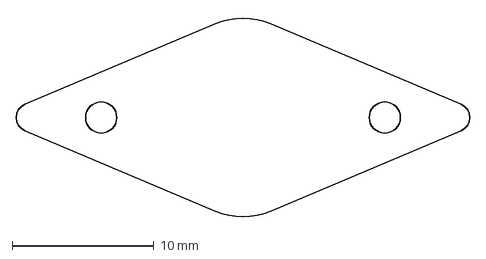
[picture p5: CAD file, 2024-07-28]
hardware/encoder/encoder_edge-Sketch.dxf
32.0 x 14.3 mm
