podwan/biWheeler/hardware/rfBat/bat_rf.step

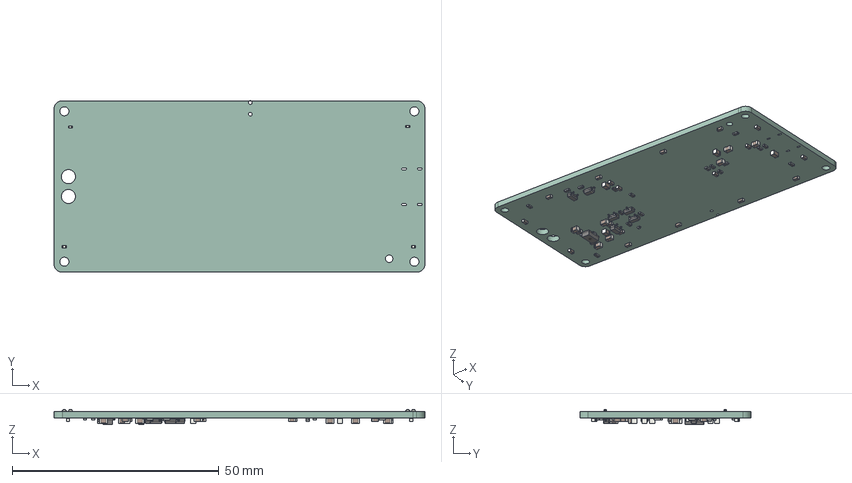
[picture p6: CAD file, 2024-07-28]
hardware/rfBat/bat_rf.step
89.8 x 41.5 x 3.75 mm
LED_0402_1005Metric x 5
CQ assembly
C_0603_1608Metric x 20
C_0805_2012Metric x 11
R_0603_1608Metric x 17
SOT_23 x 4
SOT_23_5
D_SOD_123
bat_rf_PCB
