podwan/biWheeler/hardware/rfBat/model/USB4515-GF-A--3DModel-STEP-269445.STEP

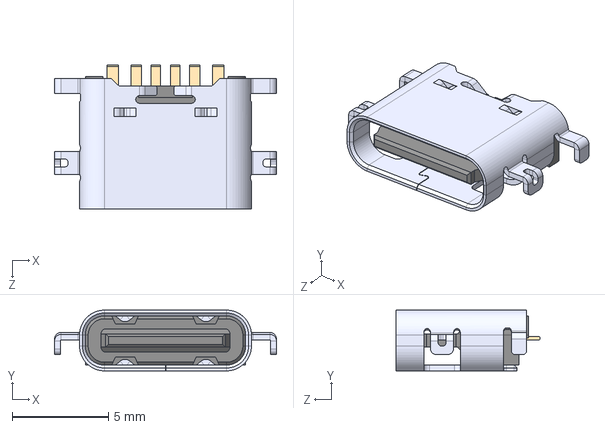
[picture p7: CAD file, 2024-07-28]
hardware/rfBat/model/USB4515-GF-A--3DModel-STEP-269445.STEP
11.5 x 3.16 x 7.50 mm
