podwan/biWheeler/mechanic/模型/后大臂X1.stl

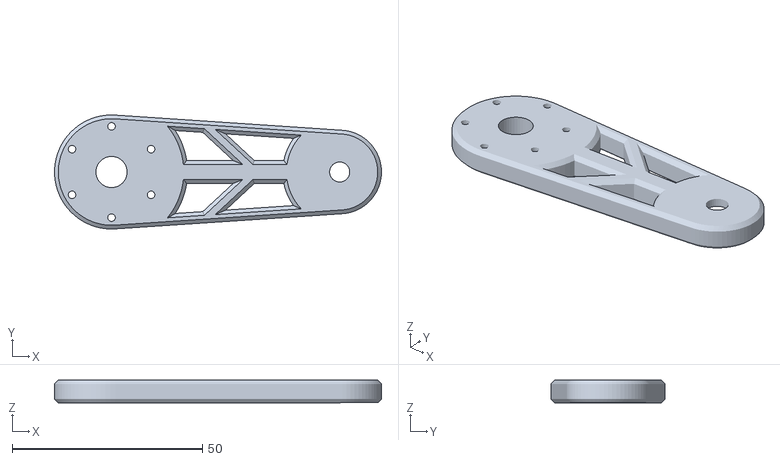
[picture p8: CAD file, 2024-07-28]
mechanic/模型/后大臂X1.stl
86.0 x 30.0 x 6.00
