podwan/biWheeler/reference/Micro-Wheeled_leg-Robot-master/1.RobotModel/Parts-Manufactured/1.3DPrint/Calf x1.stl

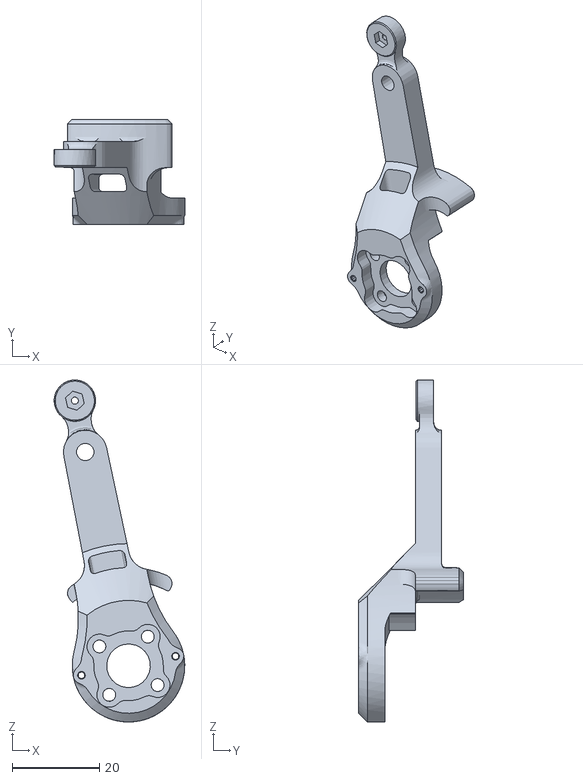
[picture p9: CAD file, 2024-07-28]
reference/Micro-Wheeled_leg-Robot-master/1.RobotModel/Parts-Manufactured/1.3DPrint/Calf x1.stl
29.9 x 24.0 x 78.4
