podwan/biWheeler/reference/Micro-Wheeled_leg-Robot-master/1.RobotModel/Parts-Manufactured/2.CNC/BodyBase-Steel.stp

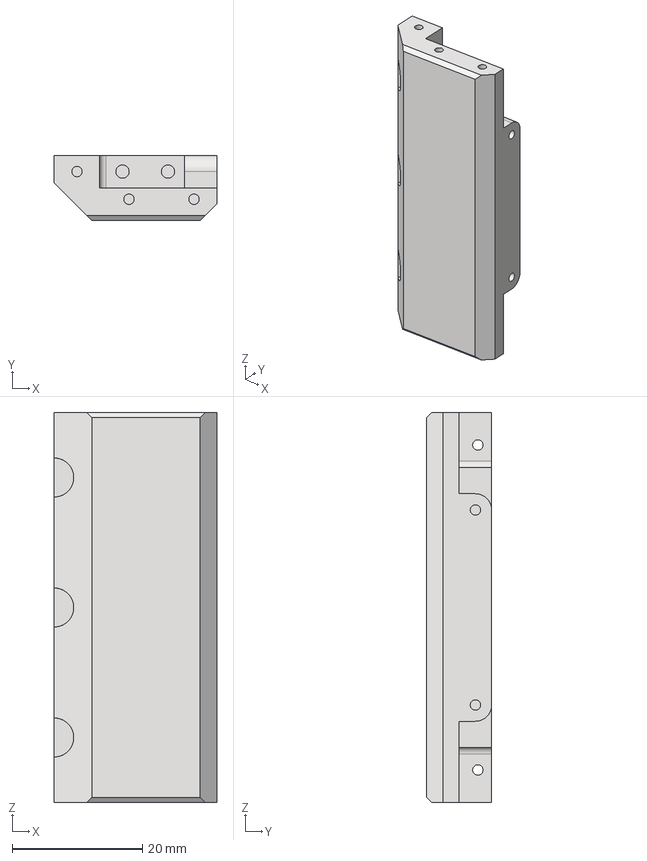
[picture p10: CAD file, 2024-07-28]
reference/Micro-Wheeled_leg-Robot-master/1.RobotModel/Parts-Manufactured/2.CNC/BodyBase-Steel.stp
25.0 x 10.1 x 60.0 mm
