podwan/biWheeler/reference/SimpleFOCMini-main/3D model/OBJ_simplefocmini.obj

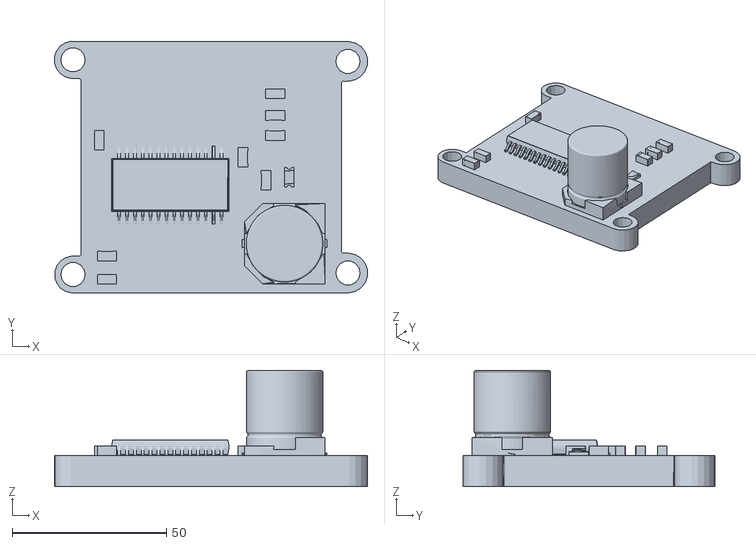
[picture p11: CAD file, 2024-07-28]
reference/SimpleFOCMini-main/3D model/OBJ_simplefocmini.obj
101.3 x 81.4 x 37.6
