podwan/biWheeler/hardware/controller/3d/TC-1102N-C-AS-B.stp

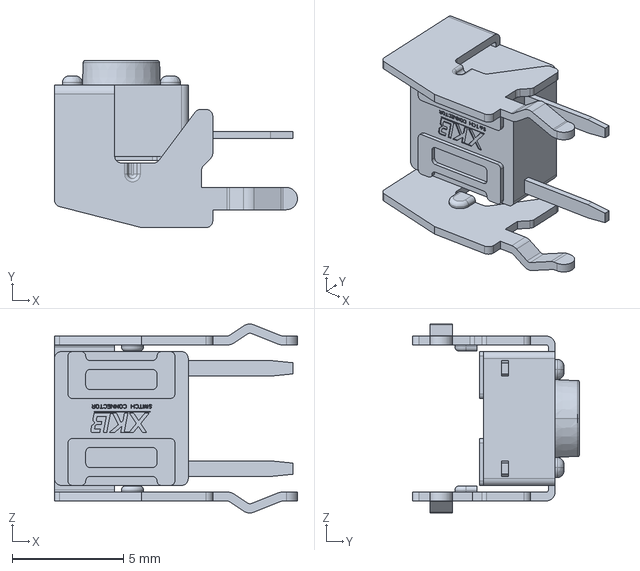
[picture p12: CAD file, 2024-07-28]
hardware/controller/3d/TC-1102N-C-AS-B.stp
10.9 x 7.50 x 8.48 mm
