podwan/biWheeler/hardware/encoder/encoder_edge.dxf

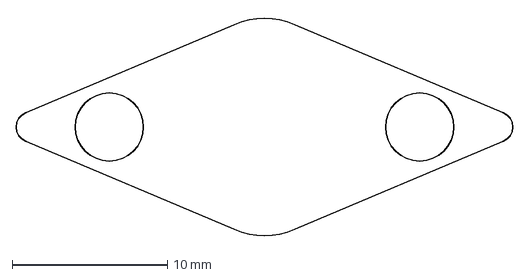
[picture p13: CAD file, 2024-07-28]
hardware/encoder/encoder_edge.dxf
32.0 x 14.3 mm
