podwan/biWheeler/mechanic/模型/舵机架X2.stl

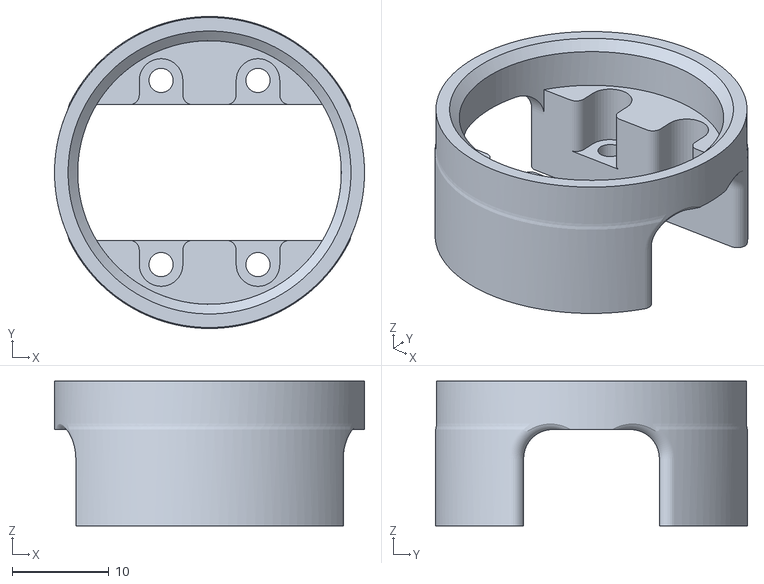
[picture p14: CAD file, 2024-07-28]
mechanic/模型/舵机架X2.stl
32.0 x 32.2 x 14.9
