podwan/biWheeler/reference/Micro-Wheeled_leg-Robot-master/1.RobotModel/Parts-Manufactured/1.3DPrint/ThighCover_MIR x1.stl

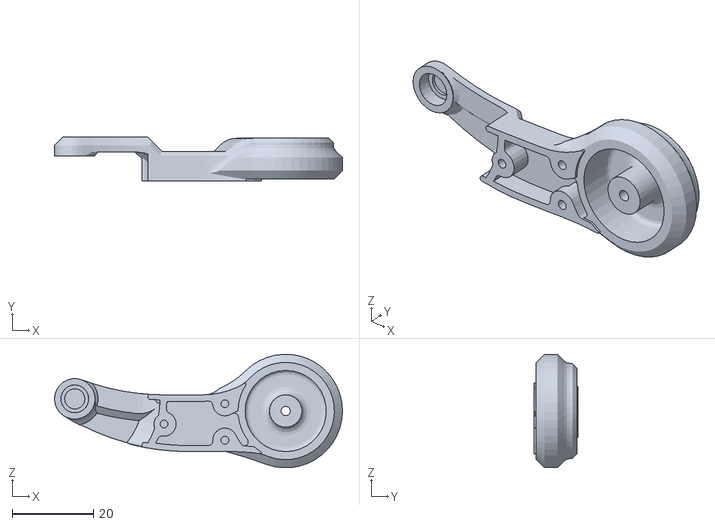
[picture p15: CAD file, 2024-07-28]
reference/Micro-Wheeled_leg-Robot-master/1.RobotModel/Parts-Manufactured/1.3DPrint/ThighCover_MIR x1.stl
71.0 x 10.8 x 28.0
