podwan/biWheeler/reference/Micro-Wheeled_leg-Robot-master/1.RobotModel/Parts-Manufactured/2.CNC/MotorBase-Aluminum6061.stp

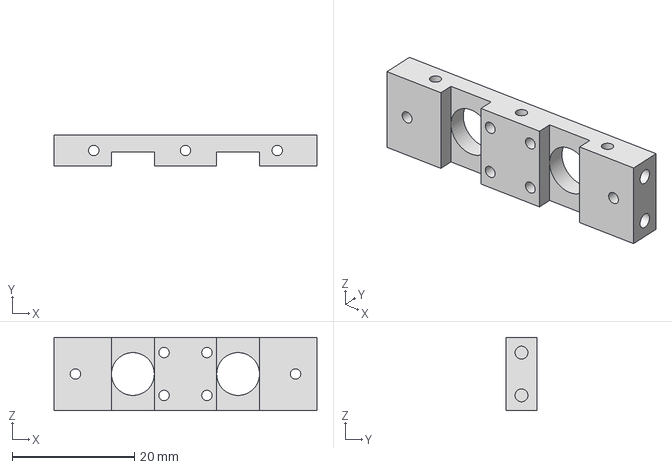
[picture p16: CAD file, 2024-07-28]
reference/Micro-Wheeled_leg-Robot-master/1.RobotModel/Parts-Manufactured/2.CNC/MotorBase-Aluminum6061.stp
43.0 x 5.00 x 12.0 mm
