podwan/biWheeler/reference/Micro-Wheeled_leg-Robot-master/1.RobotModel/Parts-Manufactured/1.3DPrint/Thigh x1.stl

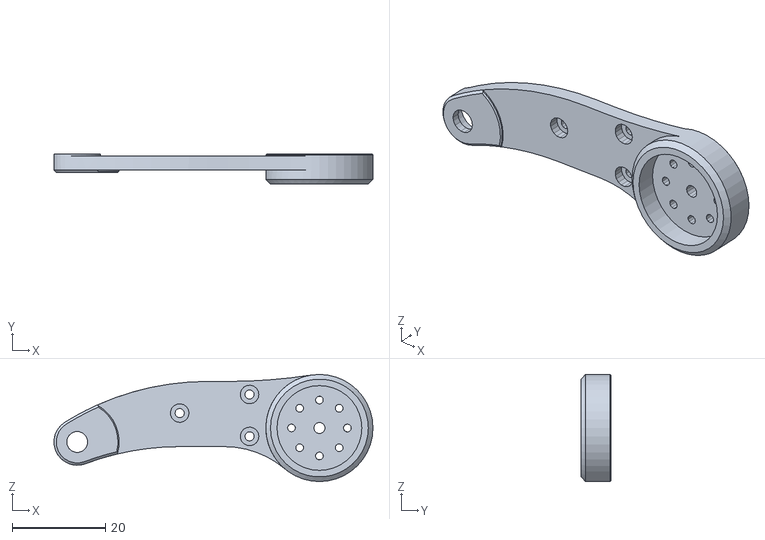
[picture p17: CAD file, 2024-07-28]
reference/Micro-Wheeled_leg-Robot-master/1.RobotModel/Parts-Manufactured/1.3DPrint/Thigh x1.stl
68.5 x 6.50 x 23.0
