podwan/biWheeler/mechanic/模型/轮毂X2.stl

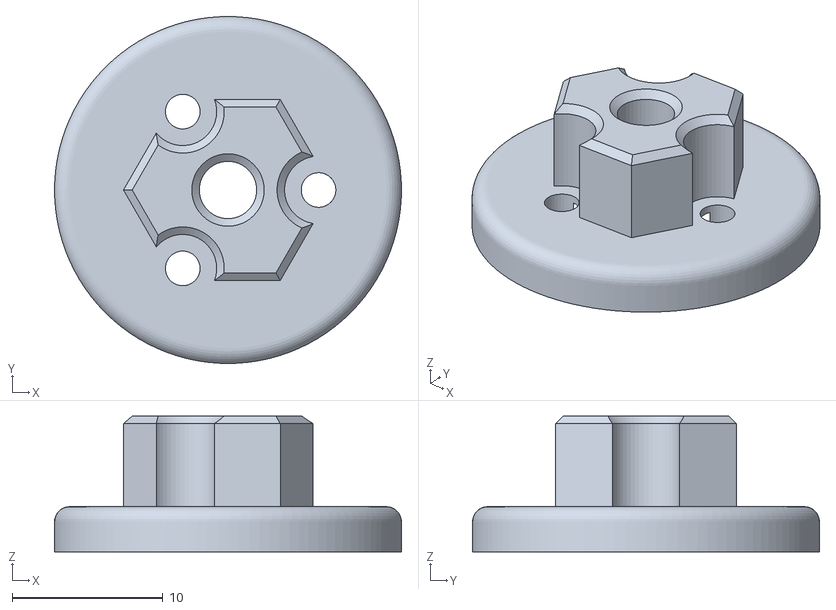
[picture p18: CAD file, 2024-07-28]
mechanic/模型/轮毂X2.stl
23.0 x 23.0 x 9.00
