podwan/biWheeler/reference/Micro-Wheeled_leg-Robot-master/1.RobotModel/Parts-Manufactured/1.3DPrint/ColumnCover x2.stl

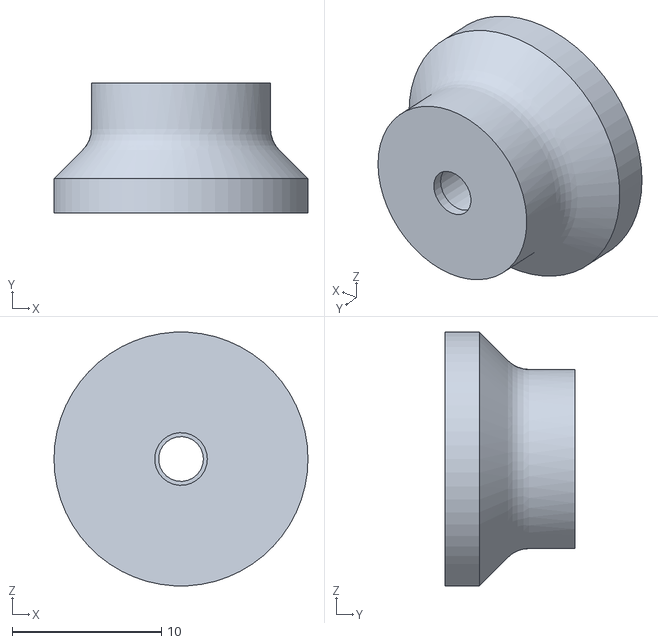
[picture p19: CAD file, 2024-07-28]
reference/Micro-Wheeled_leg-Robot-master/1.RobotModel/Parts-Manufactured/1.3DPrint/ColumnCover x2.stl
17.0 x 8.70 x 17.0
