podwan/biWheeler/mechanic/模型/轮固定X2.stl

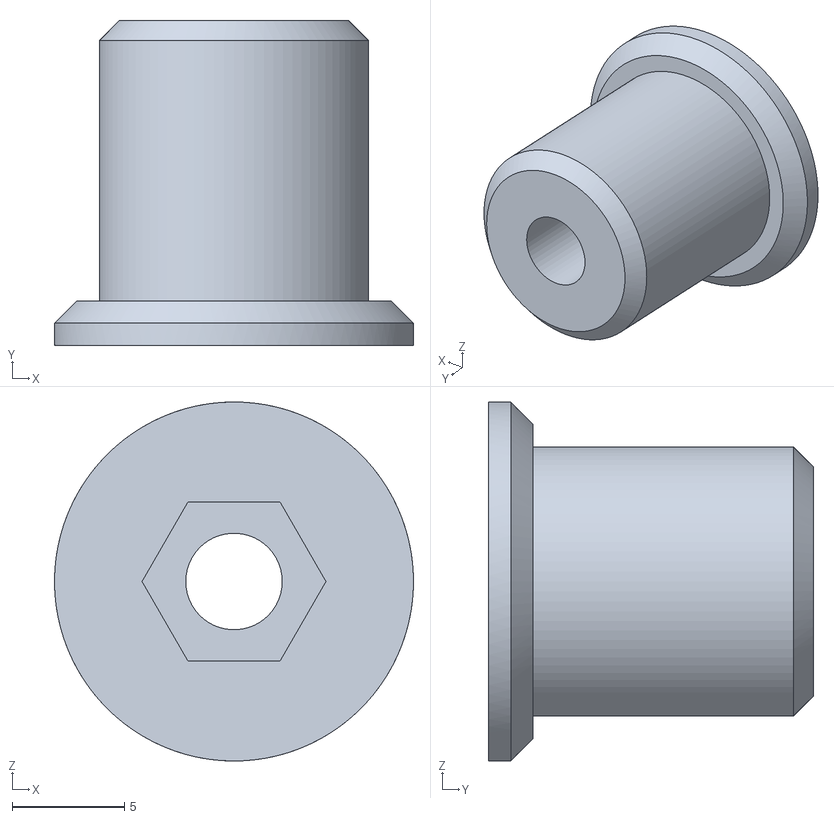
[picture p20: CAD file, 2024-07-28]
mechanic/模型/轮固定X2.stl
16.0 x 14.5 x 16.0
