podwan/biWheeler/mechanic/模型/舵机固定X1.stl

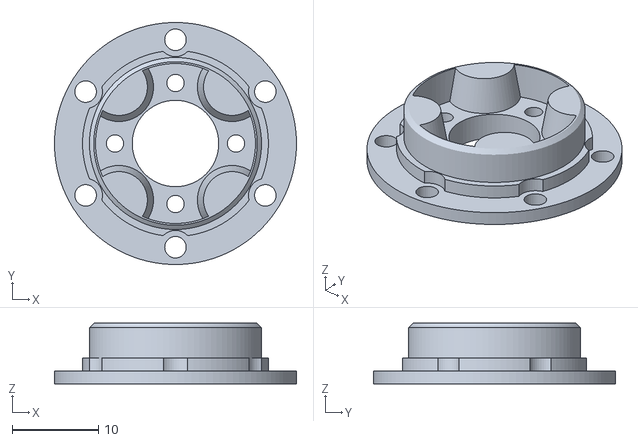
[picture p21: CAD file, 2024-07-28]
mechanic/模型/舵机固定X1.stl
28.0 x 28.0 x 7.00
