podwan/biWheeler/reference/Micro-Wheeled_leg-Robot-master/1.RobotModel/Parts-Manufactured/1.3DPrint/Hub x2.stl

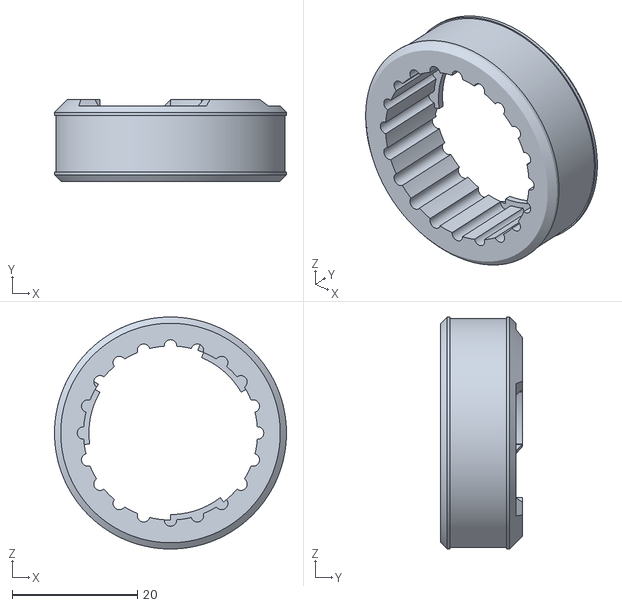
[picture p22: CAD file, 2024-07-28]
reference/Micro-Wheeled_leg-Robot-master/1.RobotModel/Parts-Manufactured/1.3DPrint/Hub x2.stl
37.0 x 13.0 x 37.0
