podwan/biWheeler/mechanic/模型/前小臂X1.stl

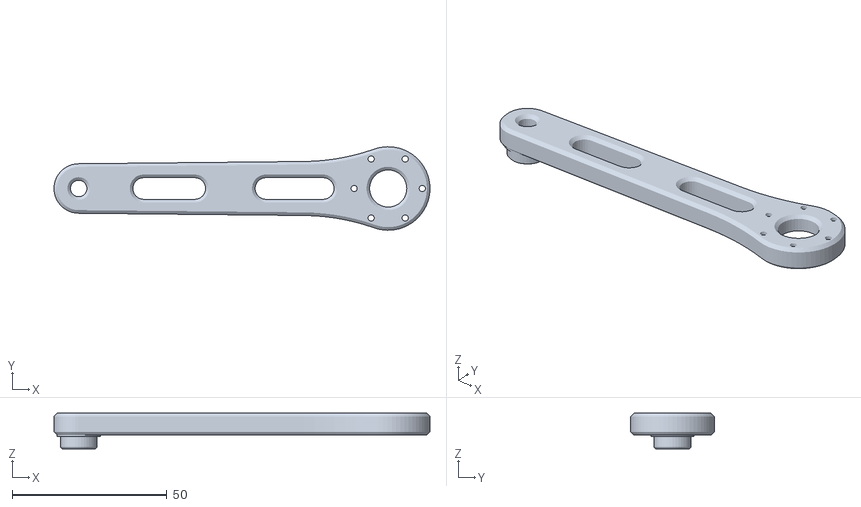
[picture p23: CAD file, 2024-07-28]
mechanic/模型/前小臂X1.stl
121.5 x 27.0 x 11.5
