podwan/biWheeler/mechanic/模型/电机固定X2.stl

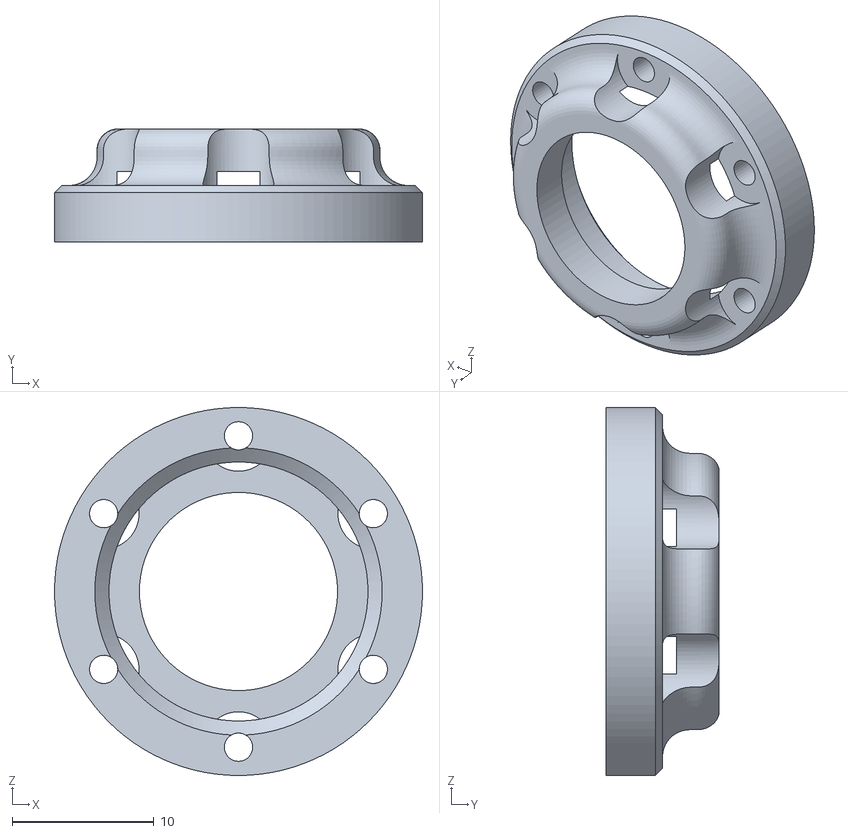
[picture p24: CAD file, 2024-07-28]
mechanic/模型/电机固定X2.stl
26.0 x 8.00 x 26.0
