podwan/biWheeler/mechanic/模型/后小臂X1.stl

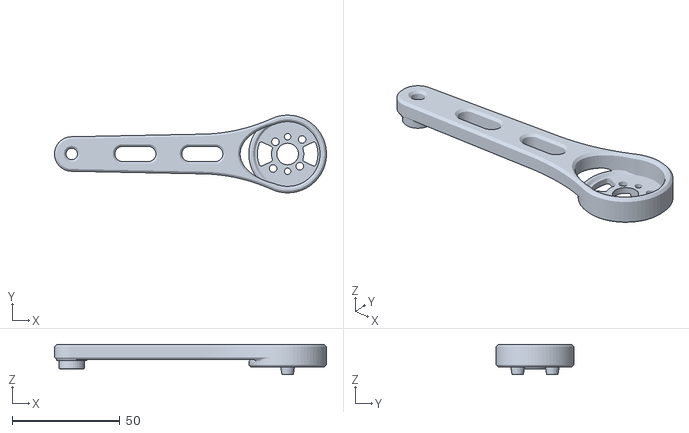
[picture p25: CAD file, 2024-07-28]
mechanic/模型/后小臂X1.stl
126.0 x 36.0 x 14.0
