podwan/biWheeler/mechanic/模型/框架.stl

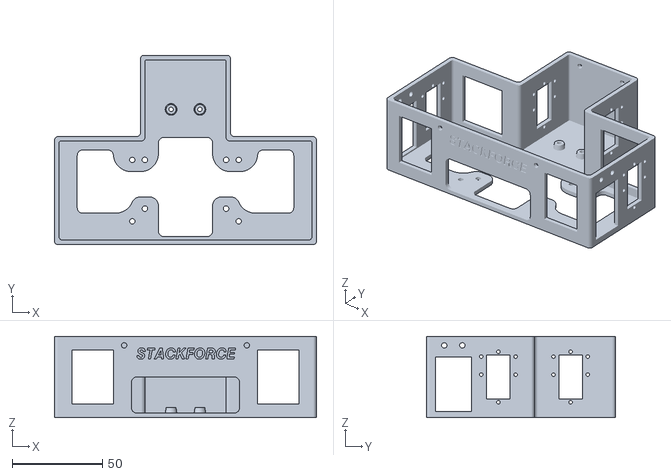
[picture p26: CAD file, 2024-07-28]
mechanic/模型/框架.stl
145.2 x 105.0 x 45.0
