podwan/biWheeler/mechanic/模型/上盖.stl

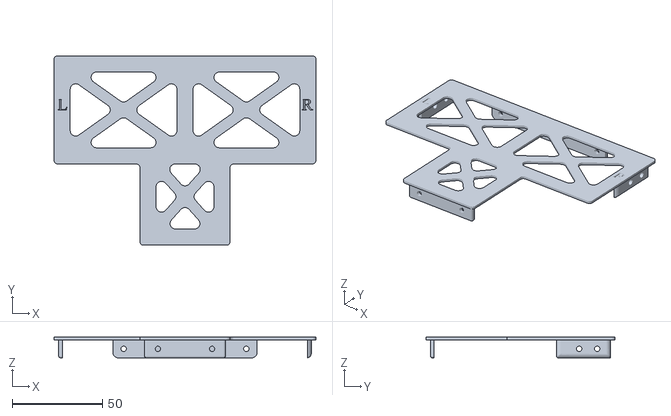
[picture p27: CAD file, 2024-07-28]
mechanic/模型/上盖.stl
145.2 x 105.0 x 11.5
