podwan/biWheeler/mechanic/模型/电池架.stl

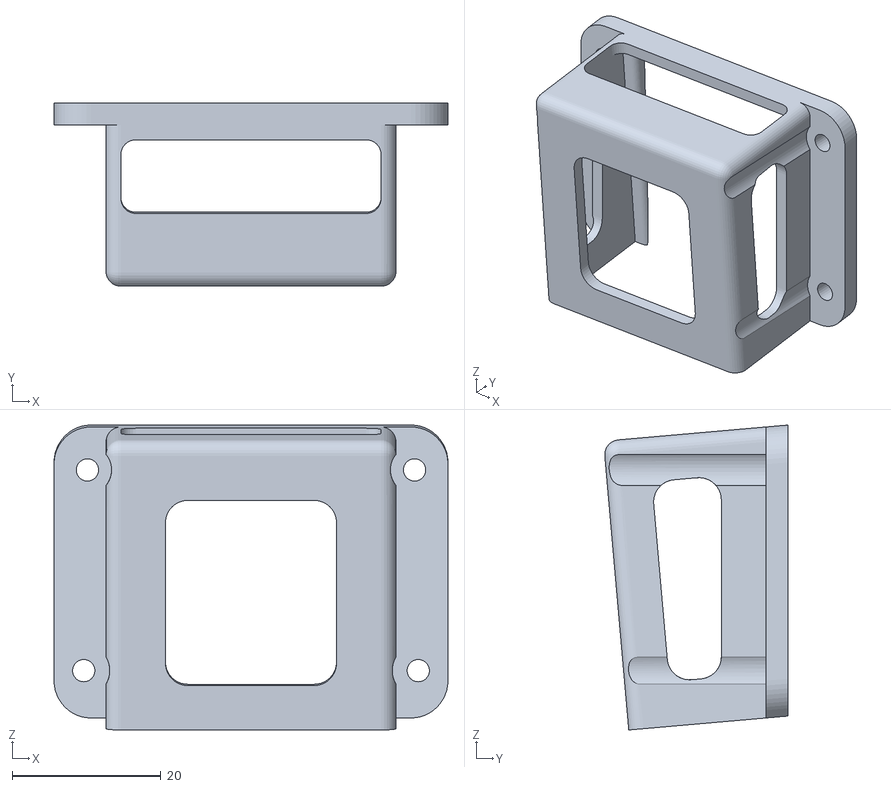
[picture p28: CAD file, 2024-07-28]
mechanic/模型/电池架.stl
53.0 x 24.7 x 41.0
