podwan/biWheeler/(list of files, cad)

Other CAD files:
reference/Micro-Wheeled_leg-Robot-master/1.RobotModel/Parts-Manufactured/3.CarbonFiberPanels/Panel.dwg
reference/Micro-Wheeled_leg-Robot-master/1.RobotModel/Parts-Manufactured/1.3DPrint/Calf_MIR x1.stl
reference/Micro-Wheeled_leg-Robot-master/1.RobotModel/Parts-Manufactured/1.3DPrint/Thigh_MIR x1.stl
reference/Micro-Wheeled_leg-Robot-master/1.RobotModel/Parts-Manufactured/1.3DPrint/ThighCover x1.stl
hardware/motorDriver/model/TPS61088RHLR.STEP
