podwan/biWheeler/reference/SimpleFOCMini-main/Gerber/How-to-order-PCB.txt

How to Order PCB

Please refer to:
https://docs.easyeda.com/en/PCB/Order-PCB
