podwan/biWheeler/(list of files, drawings)

Other design files:
reference/Micro-Wheeled_leg-Robot-master/2.Hardware/1.ControllerPCB/SourceFile/PCB_WLRobot.json
reference/Micro-Wheeled_leg-Robot-master/2.Hardware/1.ControllerPCB/SourceFile/SCH_WLRobot.json
reference/Micro-Wheeled_leg-Robot-master/2.Hardware/2.EncoderPCB/SourceFile/PCB_Encoder.json
reference/Micro-Wheeled_leg-Robot-master/2.Hardware/2.EncoderPCB/SourceFile/SCH_Encoder.json
reference/Micro-Wheeled_leg-Robot-master/2.Hardware/3.IMUPCB/SourceFile/PCB_IMU_Board.json
reference/Micro-Wheeled_leg-Robot-master/2.Hardware/4.ServoDebugPCB/SourceFile/PCB_ServoDebug.json
reference/Micro-Wheeled_leg-Robot-master/2.Hardware/4.ServoDebugPCB/SourceFile/SCH_ServoDebug.json
reference/SimpleFOCMini-main/Altium/simplefocmini_2024-04-26.pcbdoc
reference/SimpleFOCMini-main/Altium/simplefocmini_2024-04-26.schdoc
reference/SimpleFOCMini-main/EasyEDA/PCB_simplefocmini_2024-04-26.json
reference/SimpleFOCMini-main/EasyEDA/SCH_simplefocmini_2024-04-26.json
