podwan/biWheeler/hardware/motorDriver/V1.2/bldcDriver.kicad_pcb

## KiCad design hardware/motorDriver/V1.2/bldcDriver.kicad_pcb (2024-07-28, an earlier design)

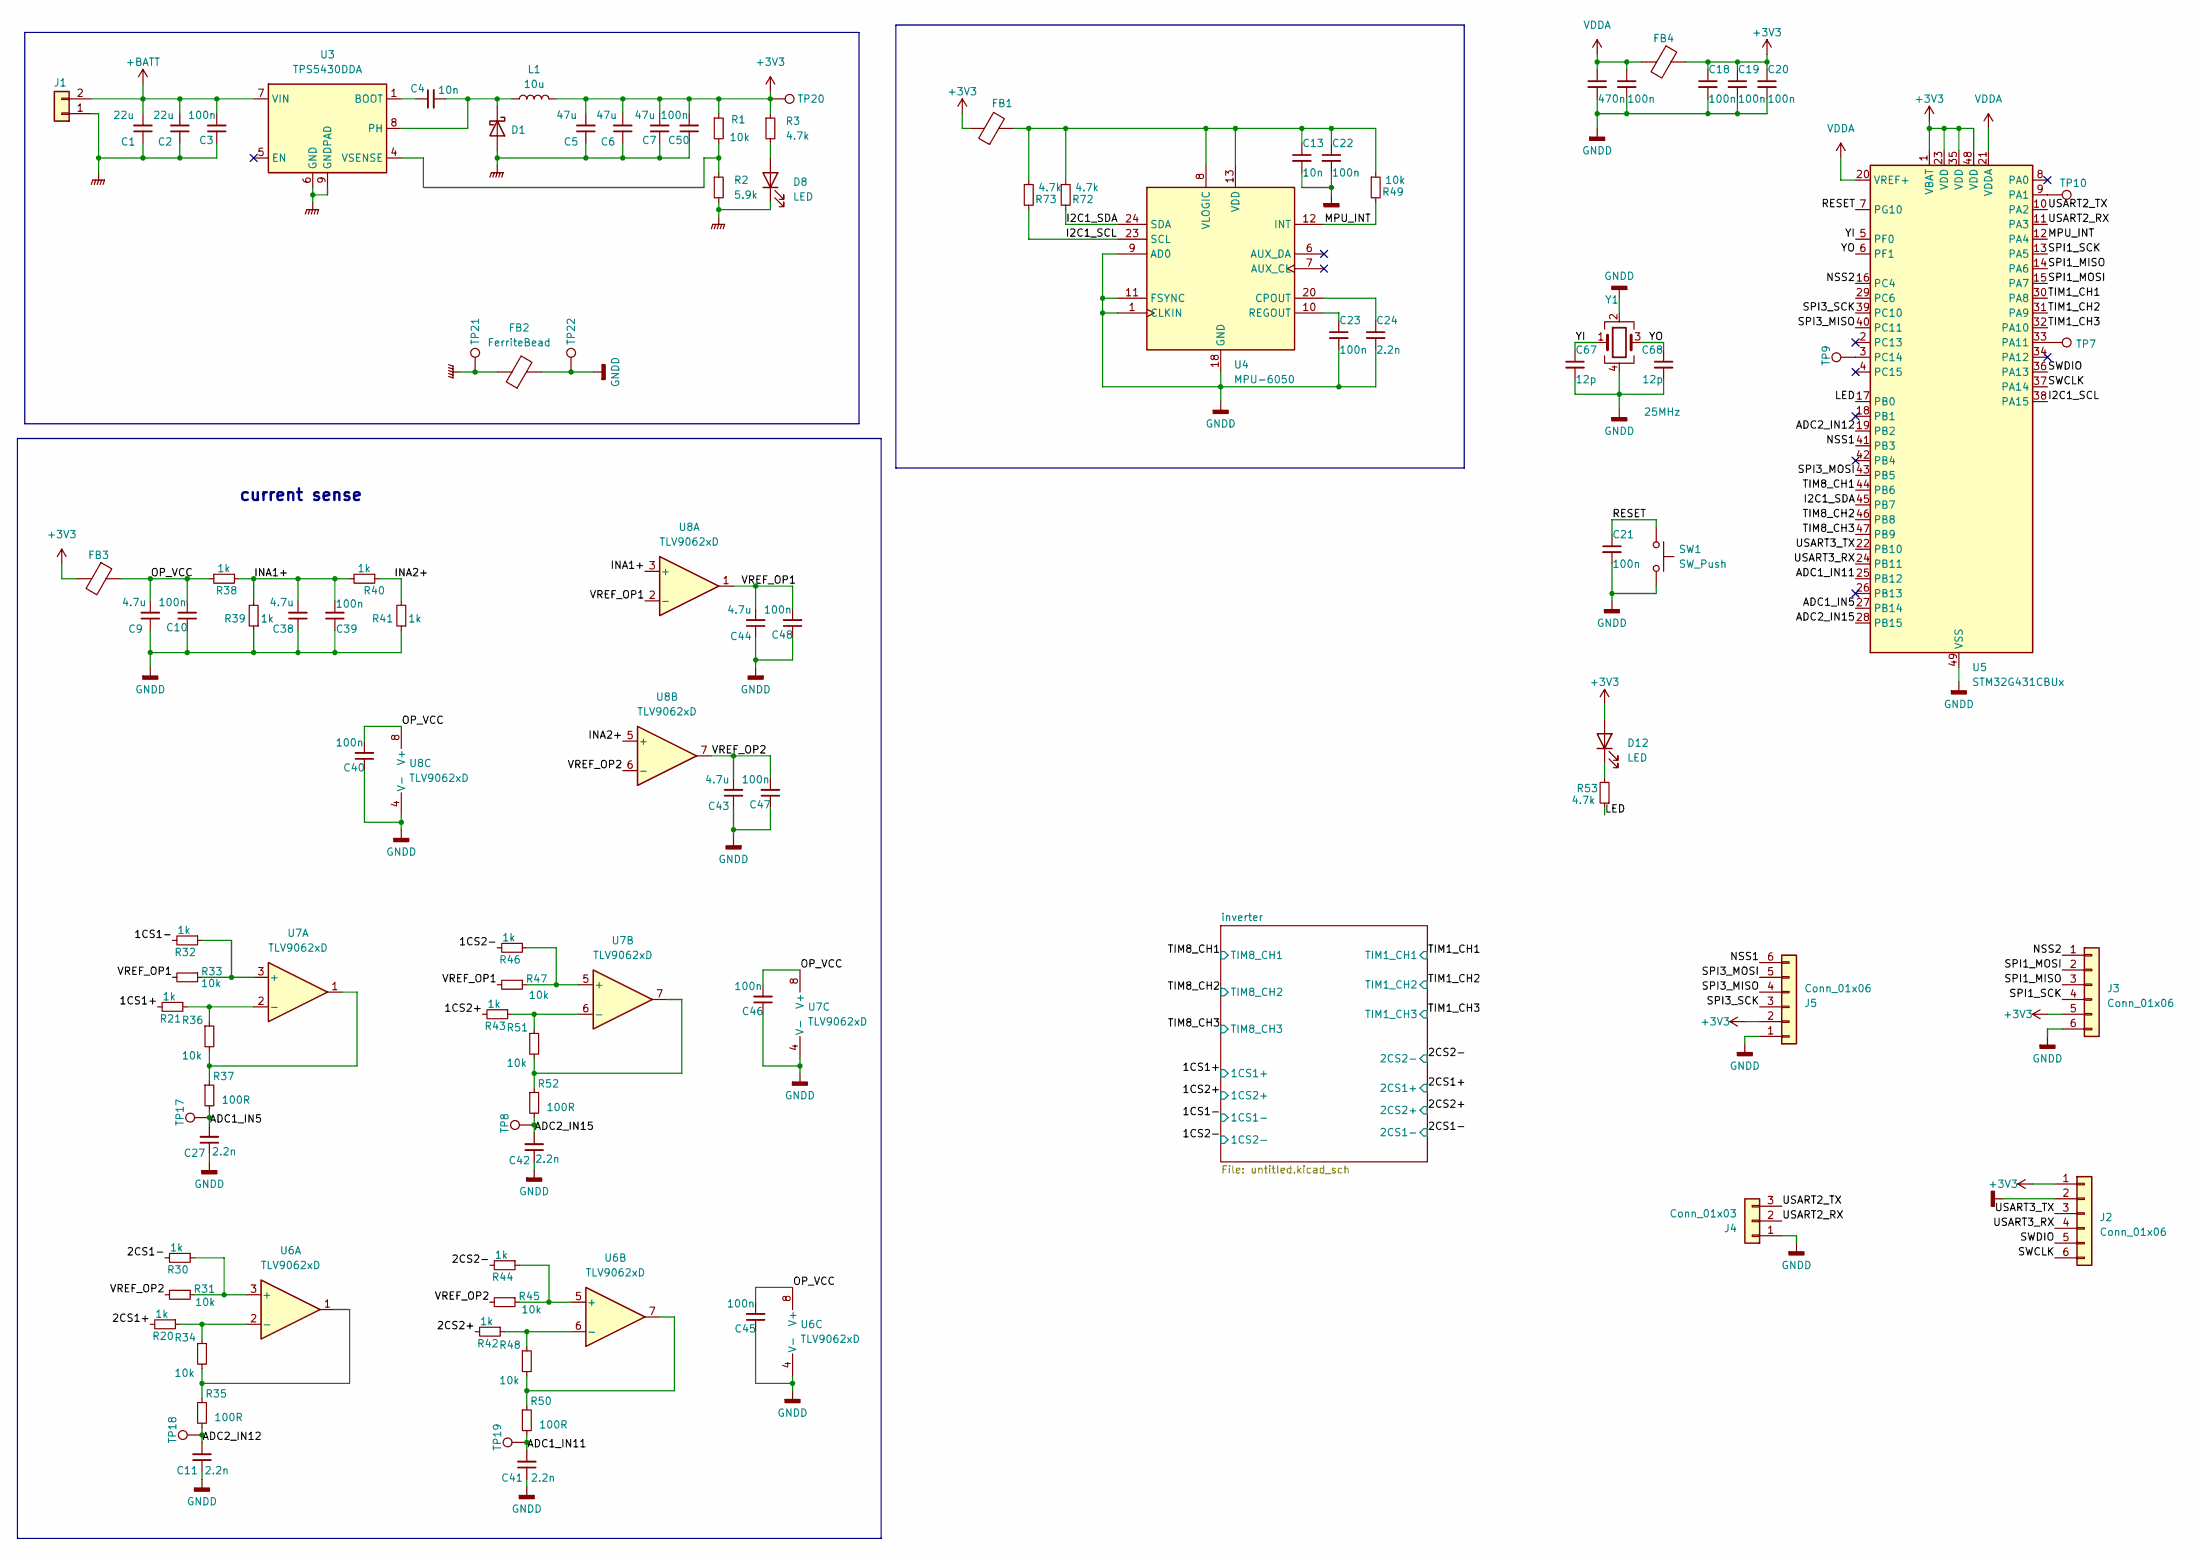
[picture p29: schematic bldcDriver.kicad_sch, bldc_controller]

Parts:
C1, C2: 22u; C_0805_2012Metric_Pad1.18x1.45mm_HandSolder
C3, C10, C17, C18, C19, C20, C21, C22, C23, C39, C40, C45, C46, C47, C48, C50: 100n; C_0603_1608Metric_Pad1.08x0.95mm_HandSolder
C4, C13: 10n; C_0603_1608Metric_Pad1.08x0.95mm_HandSolder
C5, C6, C7: 47u; C_1206_3216Metric_Pad1.33x1.80mm_HandSolder
C8: 470n; C_0603_1608Metric_Pad1.08x0.95mm_HandSolder
C9, C38, C43, C44: 4.7u; C_0603_1608Metric_Pad1.08x0.95mm_HandSolder
C11, C24, C27, C41, C42: 2.2n; C_0603_1608Metric_Pad1.08x0.95mm_HandSolder
C67, C68: 12p; C_0603_1608Metric_Pad1.08x0.95mm_HandSolder
D1: 1N5712UR; SMA_L4.3-W2.6-LS5.0-RD
D8: LED; LED_0603_1608Metric_Pad1.05x0.95mm_HandSolder
D12: LED; LED_0805_2012Metric_Pad1.15x1.40mm_HandSolder
FB1, FB3, FB4: FerriteBead; C_0603_1608Metric_Pad1.08x0.95mm_HandSolder
FB2: FerriteBead; R_1206_3216Metric_Pad1.30x1.75mm_HandSolder
J1: Conn_01x02; AMASS_XT30U-M_1x02_P5.0mm_Vertical
J2, J3, J5: Conn_01x06; CONN-SMD_6P-P1.00_MEGASTAR_ZX-SH1.0-6PWT
J4: Conn_01x03; CONN-SMD_3P-P1.00_WAFER-SH1.0-3PWB
L1: 10u; L_Taiyo-Yuden_NR-40xx_HandSoldering
R1, R31, R33, R34, R36, R45, R47, R48, R49, R51: 10k; R_0603_1608Metric_Pad0.98x0.95mm_HandSolder
R2: 5.9k; R_0603_1608Metric_Pad0.98x0.95mm_HandSolder
R3, R53, R72, R73: 4.7k; R_0603_1608Metric_Pad0.98x0.95mm_HandSolder
R20, R21, R30, R32, R38, R39, R40, R41, R42, R43, R44, R46: 1k; R_0603_1608Metric_Pad0.98x0.95mm_HandSolder
R35, R37, R50, R52: 100R; R_0603_1608Metric_Pad0.98x0.95mm_HandSolder
SW1: SW_Push; SW_SPST_B3U-1000P
TP7, TP8, TP9, TP10, TP17, TP18, TP19, TP20, TP21, TP22: TestPoint; TestPoint_Pad_D1.0mm
U3: TPS5430DDA; TI_SO-PowerPAD-8_ThermalVias
U4: MPU-6050; InvenSense_QFN-24_4x4mm_P0.5mm
U5: STM32G431CBUx; QFN-48-1EP_7x7mm_P0.5mm_EP5.6x5.6mm
U6, U7, U8: TLV9062xD; SOIC-8_3.9x4.9mm_P1.27mm
Y1: 25MHz; Crystal_SMD_SeikoEpson_FA238-4Pin_3.2x2.5mm

Connections:
+3V3: C5.2, C6.2, C7.2, C18.1, C19.1, C20.1, C50.2, D12.2 (A), FB1.1, FB3.2, FB4.1, J2.1, J3.5, J5.2, L1.2, R1.1, R3.1, TP20.1, U5.1 (VBAT), U5.23 (VDD), U5.35 (VDD), U5.48 (VDD)
+BATT: C1.2, C2.2, C3.2, J1.2, U3.7 (VIN); also elsewhere on the board
/1CS1+: R21.2; also elsewhere on the board
/1CS1-: R32.2; also elsewhere on the board
/1CS2+: R43.2; also elsewhere on the board
/1CS2-: R46.2; also elsewhere on the board
/2CS1+: R20.2; also elsewhere on the board
/2CS1-: R30.2; also elsewhere on the board
/2CS2+: R42.2; also elsewhere on the board
/2CS2-: R44.2; also elsewhere on the board
/ADC1_IN5: C27.2, R37.2, TP17.1, U5.27 (PB14)
/ADC1_IN11: C41.2, R50.2, TP19.1, U5.25 (PB12)
/ADC2_IN12: C11.2, R35.2, TP18.1, U5.19 (PB2)
/ADC2_IN15: C42.2, R52.2, TP8.1, U5.28 (PB15)
/I2C1_SCL: R73.2, U4.23 (SCL), U5.38 (PA15)
/I2C1_SDA: R72.2, U4.24 (SDA), U5.45 (PB7)
/INA1+: C38.2, C39.2, R38.1, R39.2, R40.2, U8.3 (+)
/INA2+: R40.1, R41.2, U8.5 (+)
/LED: R53.1, U5.17 (PB0)
/MPU_INT: R49.2, U4.12 (INT), U5.12 (PA4)
/NSS1: J5.6, U5.41 (PB3)
/NSS2: J3.1, U5.16 (PC4)
/OP_VCC: C9.2, C10.2, C40.2, C45.2, C46.2, FB3.1, R38.2, U6.8 (V+), U7.8 (V+), U8.8 (V+)
/RESET: C21.1, SW1.1, U5.7 (PG10)
/SPI1_MISO: J3.3, U5.14 (PA6)
/SPI1_MOSI: J3.2, U5.15 (PA7)
/SPI1_SCK: J3.4, U5.13 (PA5)
/SPI3_MISO: J5.4, U5.40 (PC11)
/SPI3_MOSI: J5.5, U5.43 (PB5)
/SPI3_SCK: J5.3, U5.39 (PC10)
/SWCLK: J2.6, U5.37 (PA14)
/SWDIO: J2.5, U5.36 (PA13)
/TIM1_CH1: U5.30 (PA8); also elsewhere on the board
/TIM1_CH2: U5.31 (PA9); also elsewhere on the board
/TIM1_CH3: U5.32 (PA10); also elsewhere on the board
/TIM8_CH1: U5.44 (PB6); also elsewhere on the board
/TIM8_CH2: U5.46 (PB8); also elsewhere on the board
/TIM8_CH3: U5.47 (PB9); also elsewhere on the board
/USART2_RX: J4.2, U5.11 (PA3)
/USART2_TX: J4.3, U5.10 (PA2)
/USART3_RX: J2.4, U5.24 (PB11)
/USART3_TX: J2.3, U5.22 (PB10)
/VREF_OP1: C44.2, C48.2, R33.2, R47.2, U8.1, U8.2 (-)
/VREF_OP2: C43.2, C47.2, R31.2, R45.2, U8.6 (-), U8.7
/YI: C67.1, U5.5 (PF0), Y1.1
/YO: C68.1, U5.6 (PF1), Y1.3
GNDD: C8.2, C9.1, C10.1, C11.1, C13.2, C17.2, C18.2, C19.2, C20.2, C21.2, C22.2, C23.2, C24.2, C27.1, C38.1, C39.1, C40.1, C41.1, C42.1, C43.1, C44.1, C45.1, C46.1, C47.1, C48.1, C67.2, C68.2, FB2.2, J2.2, J3.6, J4.1, J5.1, R39.1, R41.1, SW1.2, TP22.1, U4.1 (CLKIN), U4.9 (AD0), U4.11 (FSYNC), U4.18 (GND), U5.49 (VSS), U6.4 (V-), U7.4 (V-), U8.4 (V-), Y1.2, Y1.4
GNDPWR: C1.1, C2.1, C3.1, C5.1, C6.1, C7.1, C50.1, D1.2 (A), D8.1 (K), FB2.1, J1.1, R2.2, TP21.1, U3.6 (GND), U3.9 (GNDPAD); also elsewhere on the board
unnamed: C4.2, D1.1 (K), L1.1, U3.8 (PH)
unnamed: D8.2 (A), R3.2
unnamed: D12.1 (K), R53.2
unnamed: R34.2, R35.1, U6.1
unnamed: R36.2, R37.1, U7.1
unnamed: R48.2, R50.1, U6.7
unnamed: R51.2, R52.1, U7.7
unnamed: C4.1, U3.1 (BOOT)
unnamed: R1.2, R2.1, U3.4 (VSENSE)
unnamed: C24.1, U4.20 (CPOUT)
unnamed: C23.1, U4.10 (REGOUT)
unnamed: C13.1, C22.1, FB1.2, R49.1, R72.1, R73.1, U4.8 (VLOGIC), U4.13 (VDD)
unnamed: TP10.1, U5.9 (PA1)
unnamed: TP7.1, U5.33 (PA11)
unnamed: TP9.1, U5.3 (PC14)
unnamed: R30.1, R31.1, U6.3 (+)
unnamed: R20.1, R34.1, U6.2 (-)
unnamed: R44.1, R45.1, U6.5 (+)
unnamed: R42.1, R48.1, U6.6 (-)
unnamed: R32.1, R33.1, U7.3 (+)
unnamed: R21.1, R36.1, U7.2 (-)
unnamed: R46.1, R47.1, U7.5 (+)
unnamed: R43.1, R51.1, U7.6 (-)
VDDA: C8.1, C17.1, FB4.2, U5.20 (VREF+), U5.21 (VDDA)

Notes on the sheet:
current sense

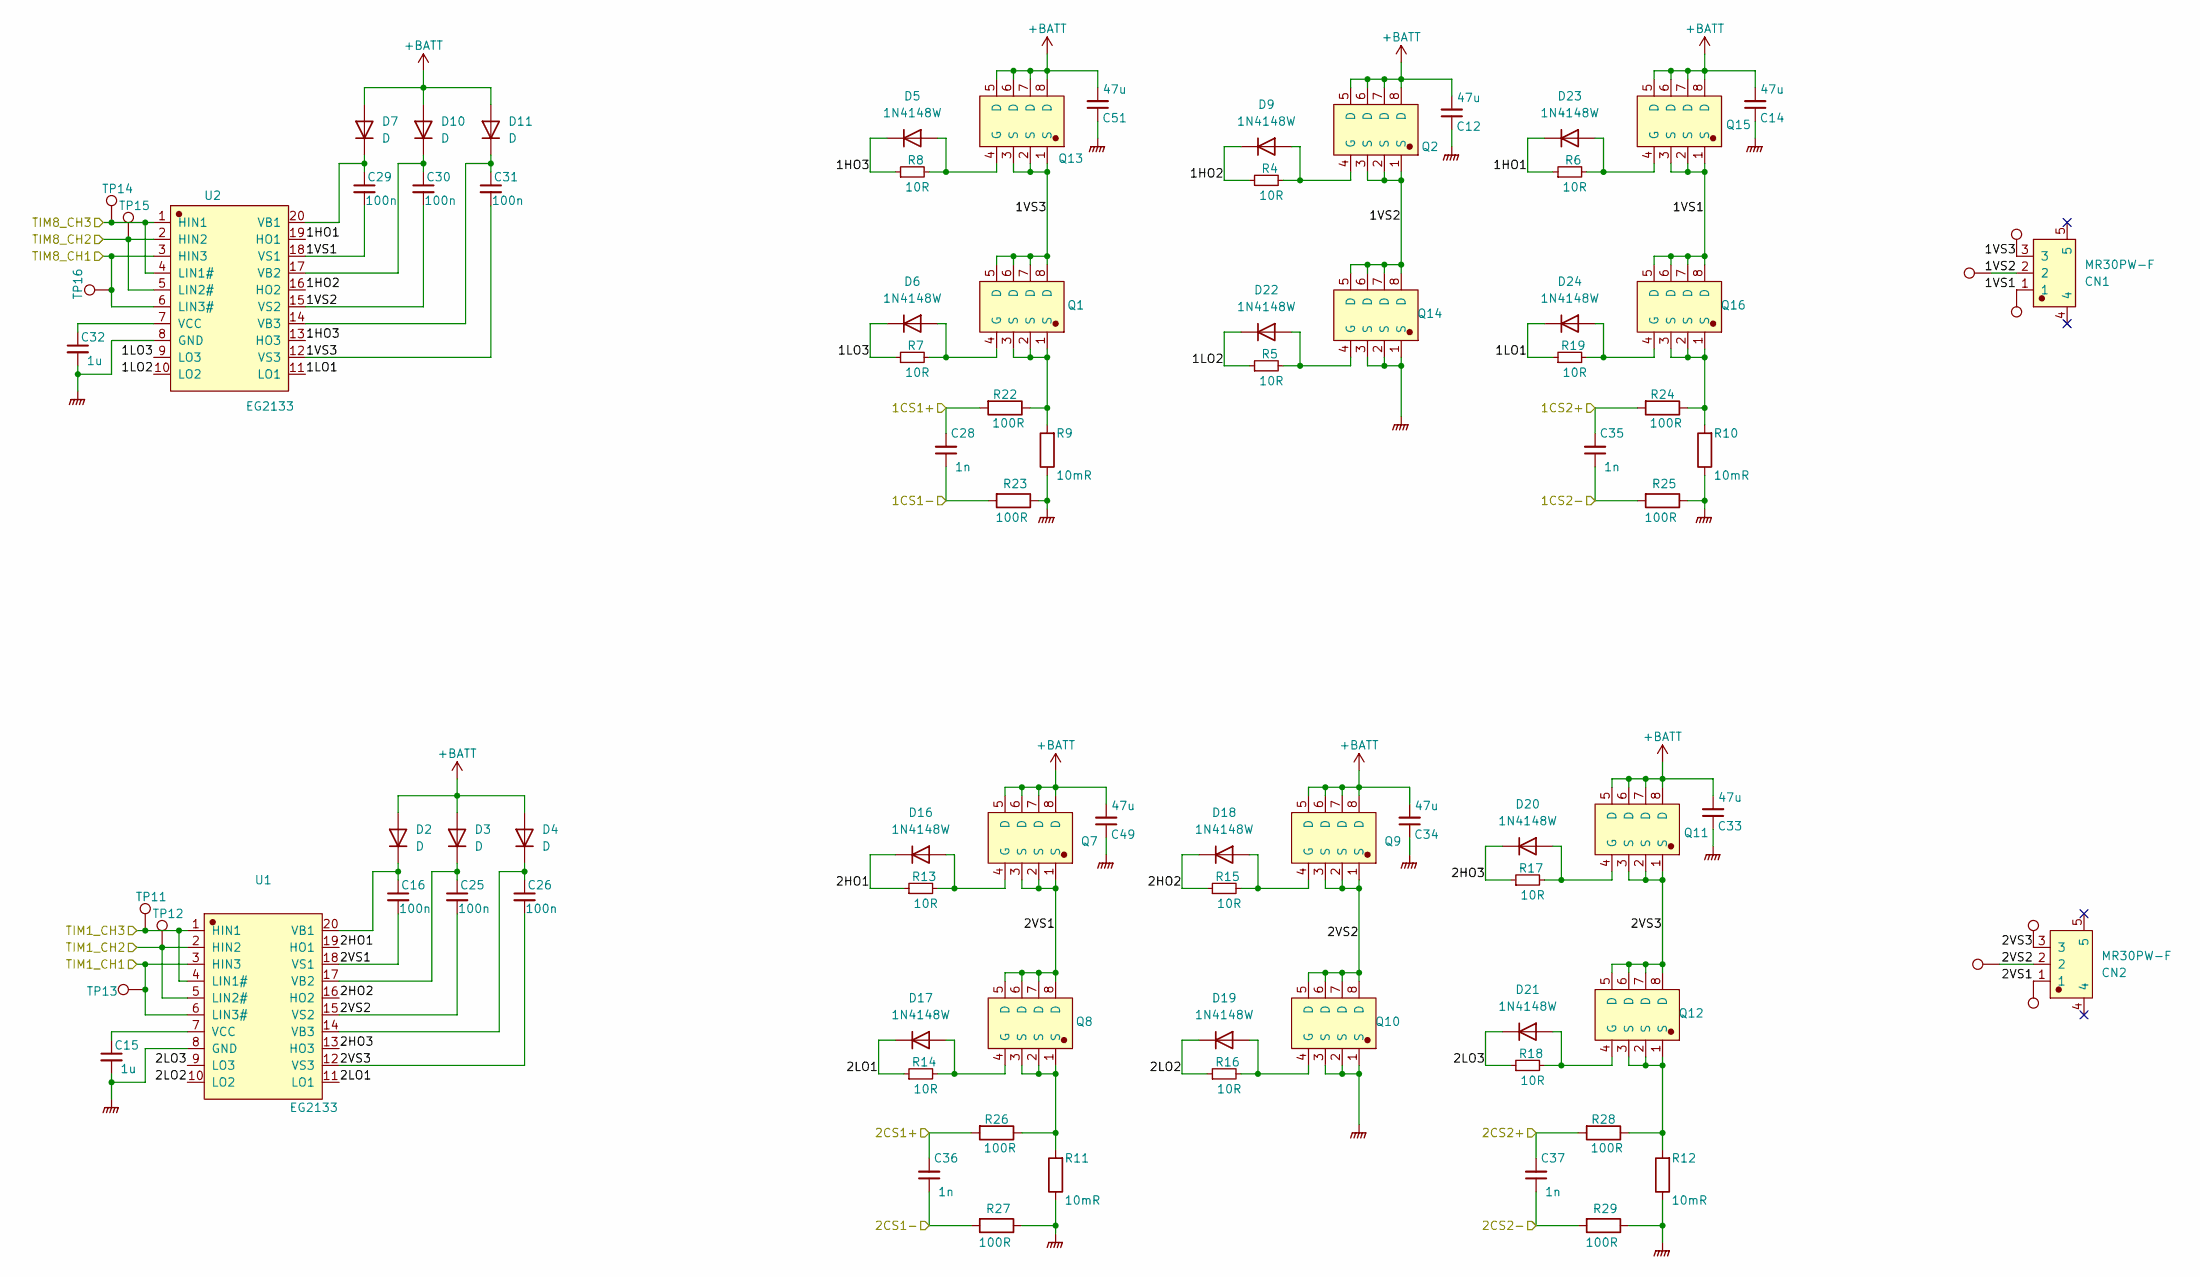
[picture p30: schematic untitled.kicad_sch]

Parts:
C12, C14, C33, C34, C49, C51: 47u; C_1206_3216Metric_Pad1.33x1.80mm_HandSolder
C15, C32: 1u; C_0603_1608Metric_Pad1.08x0.95mm_HandSolder
C16, C25, C26, C29, C30, C31: 100n; C_0603_1608Metric_Pad1.08x0.95mm_HandSolder
C28, C35, C36, C37: 1n; C_0603_1608Metric_Pad1.08x0.95mm_HandSolder
CN1, CN2: MR30PW-F; CONN-SMD_3P-P1.00_BX-SH1.0-3PWT
D2, D3, D4, D7, D10, D11: D; SOD-123FL_L2.7-W1.8-LS3.8-RD
D5, D6, D9, D16, D17, D18, D19, D20, D21, D22, D23, D24: 1N4148W; D_SOD-123
Q1, Q2, Q7, Q8, Q9, Q10, Q11, Q12, Q13, Q14, Q15, Q16: EMB09N03V; POWERTDFN-8_L3.1-W3.1-P0.65-LS3.3-BL
R4, R5, R6, R7, R8, R13, R14, R15, R16, R17, R18, R19: 10R; R_0603_1608Metric_Pad0.98x0.95mm_HandSolder
R9, R10, R11, R12: 10mR; R_1206_3216Metric_Pad1.30x1.75mm_HandSolder
R22, R23, R24, R25, R26, R27, R28, R29: 100R; R_0603_1608Metric_Pad0.98x0.95mm_HandSolder
TP1, TP2, TP3, TP4, TP5, TP6: TestPoint; TestPoint_Pad_1.0x1.0mm
TP11, TP12, TP13, TP14, TP15, TP16: TestPoint; TestPoint_Pad_D1.0mm
U1, U2: EG2133; eg2133

Connections:
+BATT: C12.2, C14.2, C33.2, C34.2, C49.2, C51.2, D2.2 (A), D3.2 (A), D4.2 (A), D7.2 (A), D10.2 (A), D11.2 (A), Q2.5 (D), Q2.6 (D), Q2.7 (D), Q2.8 (D), Q7.5 (D), Q7.6 (D), Q7.7 (D), Q7.8 (D), Q9.5 (D), Q9.6 (D), Q9.7 (D), Q9.8 (D), Q11.5 (D), Q11.6 (D), Q11.7 (D), Q11.8 (D), Q13.5 (D), Q13.6 (D), Q13.7 (D), Q13.8 (D), Q15.5 (D), Q15.6 (D), Q15.7 (D), Q15.8 (D); also elsewhere on the board
/1CS1+: C28.2, R22.2; also elsewhere on the board
/1CS1-: C28.1, R23.2; also elsewhere on the board
/1CS2+: C35.2, R24.2; also elsewhere on the board
/1CS2-: C35.1, R25.2; also elsewhere on the board
/2CS1+: C36.2, R26.2; also elsewhere on the board
/2CS1-: C36.1, R27.2; also elsewhere on the board
/2CS2+: C37.2, R28.2; also elsewhere on the board
/2CS2-: C37.1, R29.2; also elsewhere on the board
/TIM1_CH1: TP13.1, U1.3 (HIN3), U1.6 (LIN3#); also elsewhere on the board
/TIM1_CH2: TP12.1, U1.2 (HIN2), U1.5 (LIN2#); also elsewhere on the board
/TIM1_CH3: TP11.1, U1.1 (HIN1), U1.4 (LIN1#); also elsewhere on the board
/TIM8_CH1: TP16.1, U2.3 (HIN3), U2.6 (LIN3#); also elsewhere on the board
/TIM8_CH2: TP15.1, U2.2 (HIN2), U2.5 (LIN2#); also elsewhere on the board
/TIM8_CH3: TP14.1, U2.1 (HIN1), U2.4 (LIN1#); also elsewhere on the board
/inverter/1HO1: D23.1 (K), R6.1, U2.19 (HO1)
/inverter/1HO2: D9.1 (K), R4.1, U2.16 (HO2)
/inverter/1HO3: D5.1 (K), R8.1, U2.13 (HO3)
/inverter/1LO1: D24.1 (K), R19.1, U2.11 (LO1)
/inverter/1LO2: D22.1 (K), R5.1, U2.10 (LO2)
/inverter/1LO3: D6.1 (K), R7.1, U2.9 (LO3)
/inverter/1VS1: C29.2, CN1.1, Q15.1 (S), Q15.2 (S), Q15.3 (S), Q16.5 (D), Q16.6 (D), Q16.7 (D), Q16.8 (D), TP3.1, U2.18 (VS1)
/inverter/1VS2: C30.2, CN1.2, Q2.1 (S), Q2.2 (S), Q2.3 (S), Q14.5 (D), Q14.6 (D), Q14.7 (D), Q14.8 (D), TP2.1, U2.15 (VS2)
/inverter/1VS3: C31.2, CN1.3, Q1.5 (D), Q1.6 (D), Q1.7 (D), Q1.8 (D), Q13.1 (S), Q13.2 (S), Q13.3 (S), TP1.1, U2.12 (VS3)
/inverter/2HO1: D16.1 (K), R13.1, U1.19 (HO1)
/inverter/2HO2: D18.1 (K), R15.1, U1.16 (HO2)
/inverter/2HO3: D20.1 (K), R17.1, U1.13 (HO3)
/inverter/2LO1: D17.1 (K), R14.1, U1.11 (LO1)
/inverter/2LO2: D19.1 (K), R16.1, U1.10 (LO2)
/inverter/2LO3: D21.1 (K), R18.1, U1.9 (LO3)
/inverter/2VS1: C16.2, CN2.1, Q7.1 (S), Q7.2 (S), Q7.3 (S), Q8.5 (D), Q8.6 (D), Q8.7 (D), Q8.8 (D), TP6.1, U1.18 (VS1)
/inverter/2VS2: C25.2, CN2.2, Q9.1 (S), Q9.2 (S), Q9.3 (S), Q10.5 (D), Q10.6 (D), Q10.7 (D), Q10.8 (D), TP5.1, U1.15 (VS2)
/inverter/2VS3: C26.2, CN2.3, Q11.1 (S), Q11.2 (S), Q11.3 (S), Q12.5 (D), Q12.6 (D), Q12.7 (D), Q12.8 (D), TP4.1, U1.12 (VS3)
GNDPWR: C12.1, C14.1, C15.2, C32.2, C33.1, C34.1, C49.1, C51.1, Q10.1 (S), Q10.2 (S), Q10.3 (S), Q14.1 (S), Q14.2 (S), Q14.3 (S), R9.1, R10.1, R11.1, R12.1, R23.1, R25.1, R27.1, R29.1, U1.8 (GND), U2.8 (GND); also elsewhere on the board
unnamed: C16.1, D2.1 (K), U1.20 (VB1)
unnamed: C25.1, D3.1 (K), U1.17 (VB2)
unnamed: C26.1, D4.1 (K), U1.14 (VB3)
unnamed: D5.2 (A), Q13.4 (G), R8.2
unnamed: D6.2 (A), Q1.4 (G), R7.2
unnamed: C29.1, D7.1 (K), U2.20 (VB1)
unnamed: D9.2 (A), Q2.4 (G), R4.2
unnamed: C30.1, D10.1 (K), U2.17 (VB2)
unnamed: C31.1, D11.1 (K), U2.14 (VB3)
unnamed: D16.2 (A), Q7.4 (G), R13.2
unnamed: D17.2 (A), Q8.4 (G), R14.2
unnamed: D18.2 (A), Q9.4 (G), R15.2
unnamed: D19.2 (A), Q10.4 (G), R16.2
unnamed: D20.2 (A), Q11.4 (G), R17.2
unnamed: D21.2 (A), Q12.4 (G), R18.2
unnamed: D22.2 (A), Q14.4 (G), R5.2
unnamed: D23.2 (A), Q15.4 (G), R6.2
unnamed: D24.2 (A), Q16.4 (G), R19.2
unnamed: Q1.1 (S), Q1.2 (S), Q1.3 (S), R9.2, R22.1
unnamed: Q8.1 (S), Q8.2 (S), Q8.3 (S), R11.2, R26.1
unnamed: Q12.1 (S), Q12.2 (S), Q12.3 (S), R12.2, R28.1
unnamed: Q16.1 (S), Q16.2 (S), Q16.3 (S), R10.2, R24.1
unnamed: C15.1, U1.7 (VCC)
unnamed: C32.1, U2.7 (VCC)

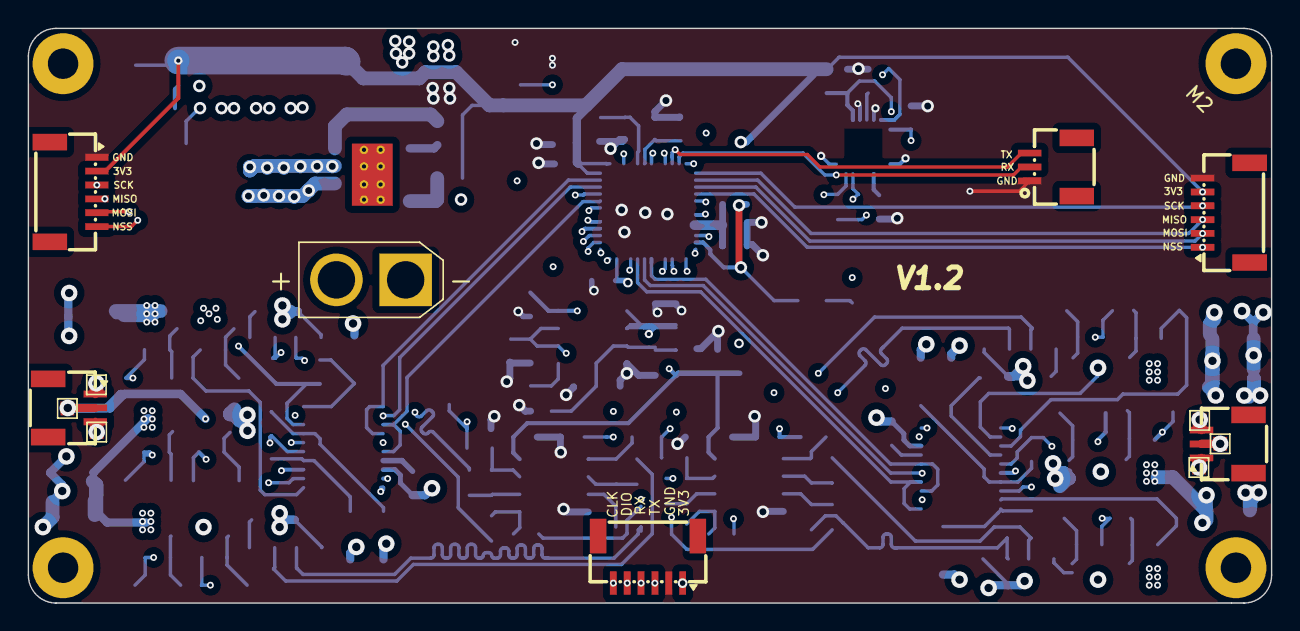
[picture p31: board bldcDriver.kicad_pcb from above]

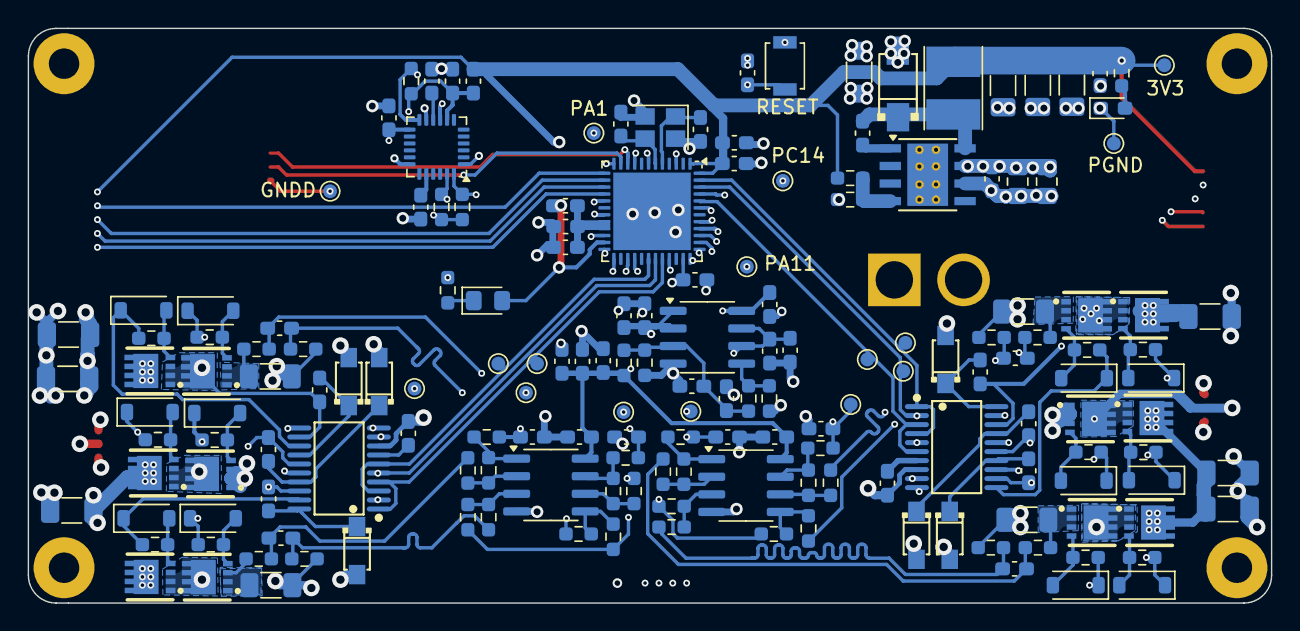
[picture p32: board bldcDriver.kicad_pcb from below]

Board: 4 copper layers, 89.8 x 41.5 mm, 185 parts (172 on the bottom side), 114 nets.
