podwan/biWheeler/hardware/controller/controller.kicad_pcb

## KiCad design hardware/controller/controller.kicad_pcb (2024-07-28)

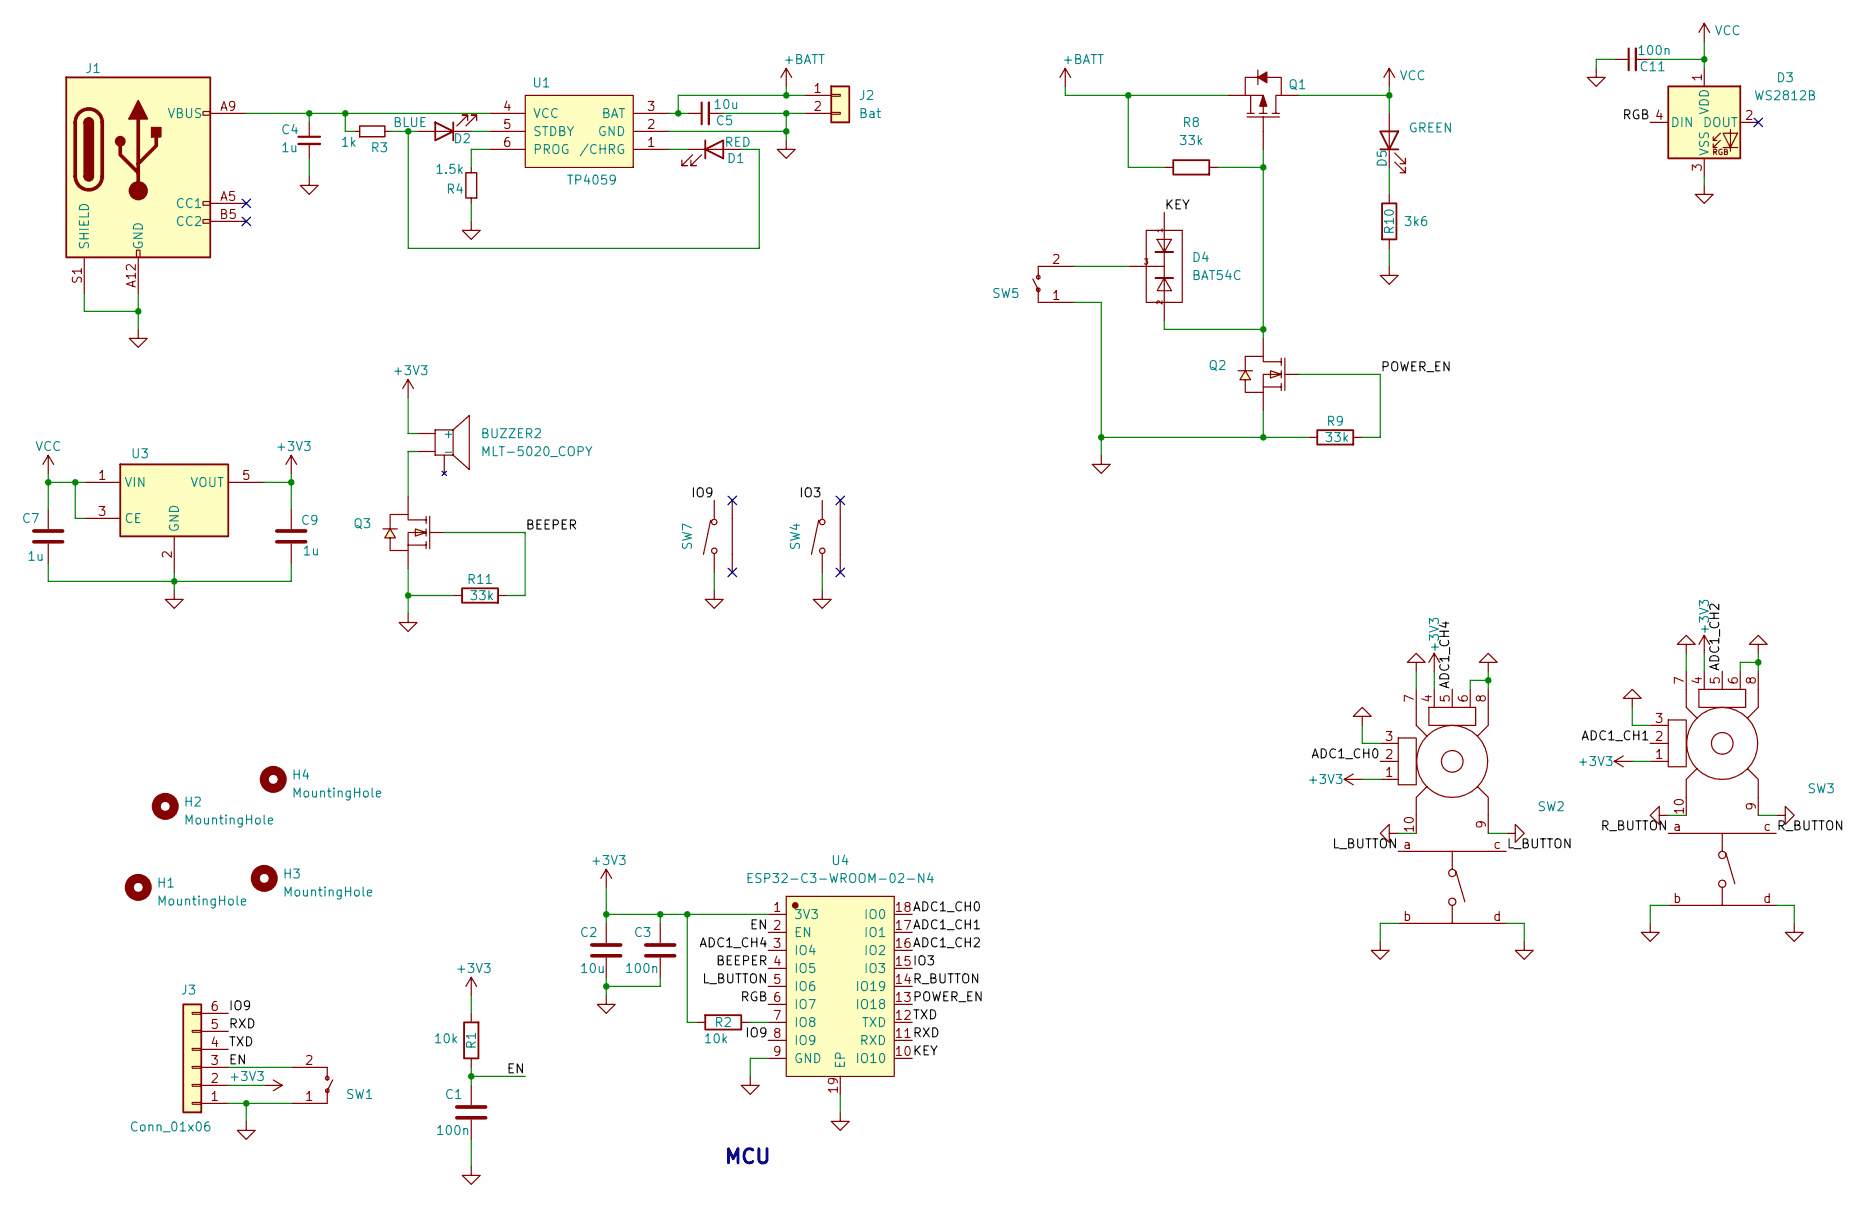
[picture p33: schematic controller.kicad_sch]

Parts:
BUZZER2: MLT-5020_COPY; BUZ-SMD_L5.0-W5.5-P4.60
C1, C3, C11: 100n; C_0603_1608Metric_Pad1.08x0.95mm_HandSolder
C2, C5: 10u; C_0805_2012Metric_Pad1.18x1.45mm_HandSolder
C4, C7, C9: 1u; C_0603_1608Metric_Pad1.08x0.95mm_HandSolder
D1: RED; LED_0603_1608Metric_Pad1.05x0.95mm_HandSolder
D2: BLUE; LED_0603_1608Metric_Pad1.05x0.95mm_HandSolder
D3: WS2812B; LED_WS2812B_PLCC4_5.0x5.0mm_P3.2mm
D4: BAT54C; SOT-23
D5: GREEN; LED_0603_1608Metric_Pad1.05x0.95mm_HandSolder
H1, H2, H3, H4: MountingHole; MountingHole_2.2mm_M2_Pad
J1: USB_C_Receptacle_PowerOnly_6P; USB-C-SMD_HX-TYPE-C-6PIN
J2: Bat; CONN-SMD_2P-P2.54-XH2.54-WT
J3: Conn_01x06; CONN-SMD_6P-P1.00_XYECONN_XY-SH1.0-6A61
Q1: AO3401; SOT-23
Q2, Q3: AllPower__AP2300; SOT-23
R1, R2: 10k; R_0603_1608Metric_Pad0.98x0.95mm_HandSolder
R3: 1k; R_0603_1608Metric_Pad0.98x0.95mm_HandSolder
R4: 1.5k; R_0603_1608Metric_Pad0.98x0.95mm_HandSolder
R8, R9, R11: 33k; R_0603_1608Metric_Pad0.98x0.95mm_HandSolder
R10: 3k6; R_0603_1608Metric_Pad0.98x0.95mm_HandSolder
SW1, SW5: TS-1199A-B-B; SW-SMD_L6.0-W6.0-P6.00-LS6.6
SW2, SW3: RKJXV1224005; SW-TH_RKJXV1224005
SW4, SW7: TC-1102N-C-AS-B; SW-TH_TC-1102N-C-AS-B
U1: TP4059; SOT-23-6_L2.9-W1.6-P0.95-LS2.8-BR
U3: XC6220B331MR; SOT-23-5
U4: ESP32-C3-WROOM-02-N4; ESP32-C3-WROOM-02

Connections:
+3V3: BUZZER2.1 (+), C2.1, C3.1, C9.1, J3.2, R1.2, R2.2, SW2.1 (B), SW2.4 (A), SW3.1 (B), SW3.4 (A), U3.5 (VOUT), U4.1 (3V3)
+BATT: C5.1, J2.1, Q1.2 (S), R8.1, U1.3 (BAT)
/ADC1_CH0: SW2.2 (DTA), U4.18 (IO0)
/ADC1_CH1: SW3.2 (DTA), U4.17 (IO1)
/ADC1_CH2: SW3.5 (DTA), U4.16 (IO2)
/ADC1_CH4: SW2.5 (DTA), U4.3 (IO4)
/BEEPER: Q3.1 (G), R11.2, U4.4 (IO5)
/EN: C1.1, J3.3, R1.1, SW1.2, U4.2 (EN)
/IO3: SW4.2, U4.15 (IO3)
/IO9: J3.6, SW7.2, U4.8 (IO9)
/KEY: D4.1 (A), U4.10 (IO10)
/L_BUTTON: SW2.a, SW2.c, U4.5 (IO6)
/POWER_EN: Q2.1 (G), R9.2, U4.13 (IO18)
/RGB: D3.4 (DIN), U4.6 (IO7)
/RXD: J3.5, U4.11 (RXD)
/R_BUTTON: SW3.a, SW3.c, U4.14 (IO19)
/TXD: J3.4, U4.12 (TXD)
GND: C1.2, C2.2, C3.2, C4.2, C5.2, C7.2, C9.2, C11.1, D3.3 (VSS), J1.A12 (GND), J1.B12 (GND), J1.S1 (SHIELD), J2.2, J3.1, Q2.2 (S), Q3.2 (S), R4.1, R9.1, R10.2, R11.1, SW1.1, SW2.3 (A), SW2.6 (B), SW2.7 (GND), SW2.8 (GND), SW2.9 (GND), SW2.10 (GND), SW2.b, SW2.d, SW3.3 (A), SW3.6 (B), SW3.7 (GND), SW3.8 (GND), SW3.9 (GND), SW3.10 (GND), SW3.b, SW3.d, SW4.1, SW5.1, SW7.1, U1.2 (GND), U3.2 (GND), U4.9 (GND), U4.19 (EP)
unnamed: BUZZER2.2 (-), Q3.3 (D)
unnamed: D1.2 (A), D2.2 (A), R3.2
unnamed: D1.1 (K), U1.1 (/CHRG)
unnamed: D2.1 (K), U1.5 (STDBY)
unnamed: D4.3 (C), SW5.2
unnamed: D5.1 (K), R10.1
unnamed: D4.2 (A), Q1.1 (G), Q2.3 (D), R8.2
unnamed: R4.2, U1.6 (PROG)
unnamed: C4.1, J1.A9 (VBUS), J1.B9 (VBUS), R3.1, U1.4 (VCC)
unnamed: R2.1, U4.7 (IO8)
VCC: C7.1, C11.2, D3.1 (VDD), D5.2 (A), Q1.3 (D), U3.1 (VIN), U3.3 (CE)

Notes on the sheet:
MCU

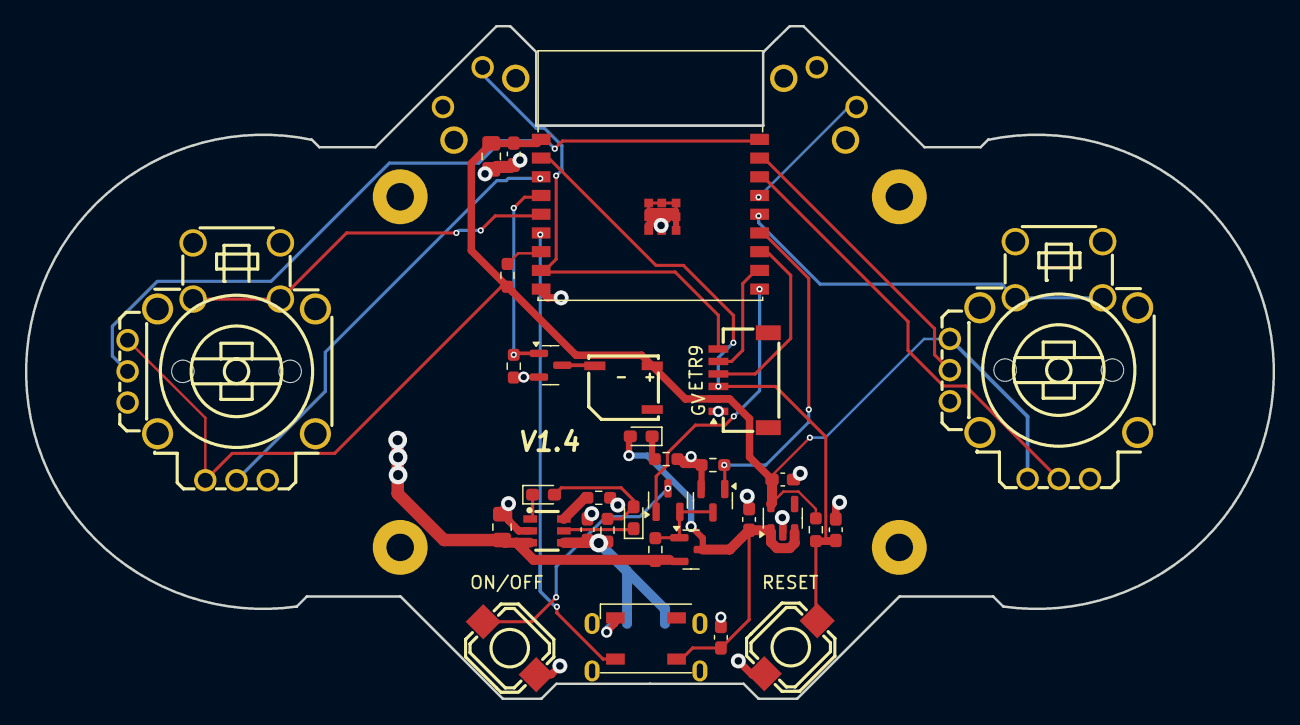
[picture p34: board controller.kicad_pcb from above]

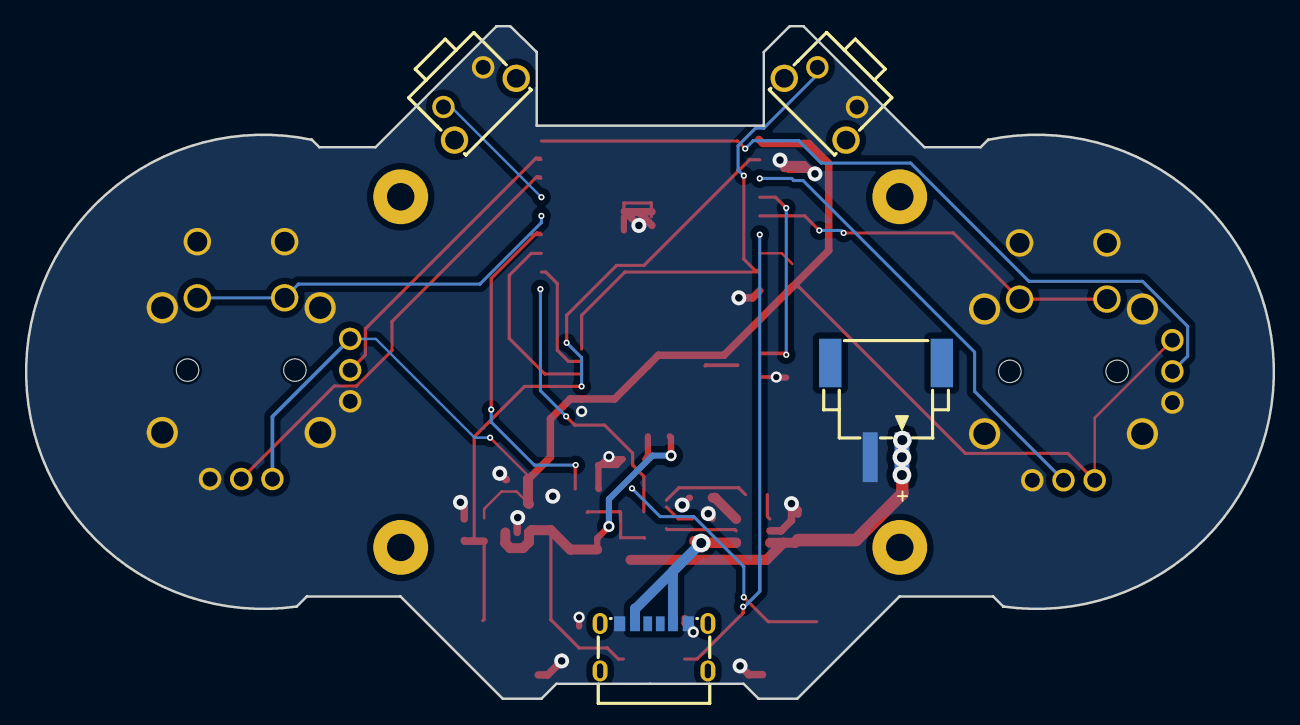
[picture p35: board controller.kicad_pcb from below]

Board: 2 copper layers, 100.0 x 53.9 mm, 41 parts (4 on the bottom side), 29 nets.
