podwan/biWheeler/hardware/rfBat/bat_rf.kicad_pcb

## KiCad design hardware/rfBat/bat_rf.kicad_pcb (2024-07-28)

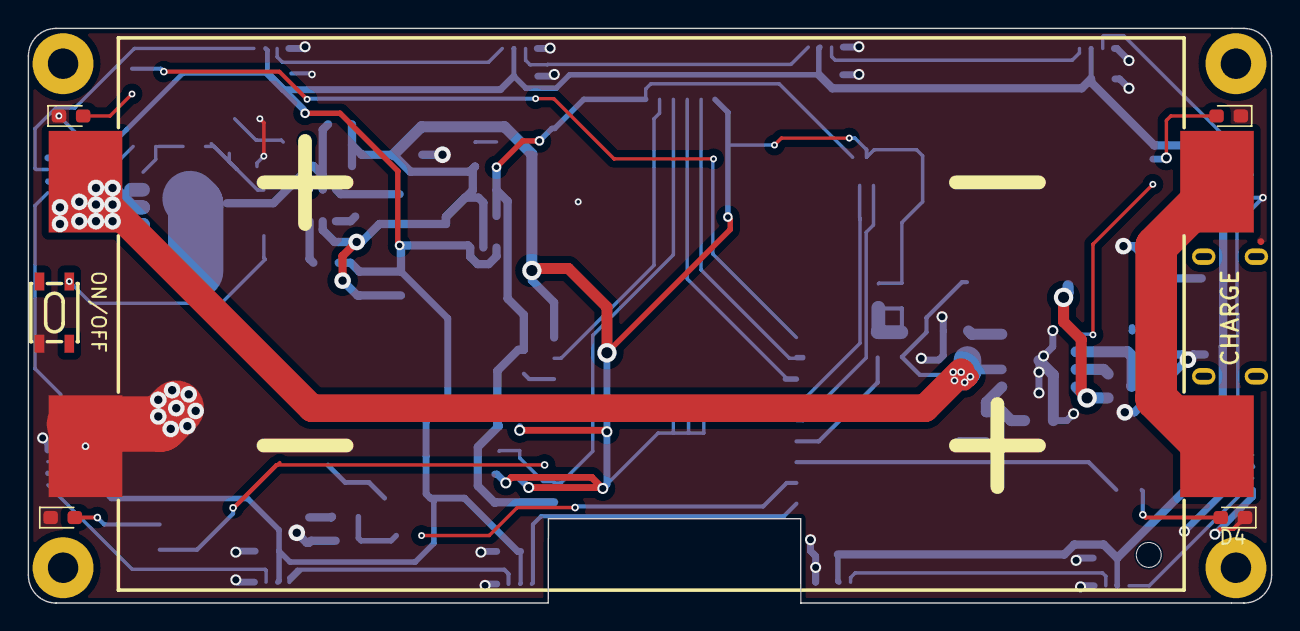
[picture p36: board bat_rf.kicad_pcb from above]

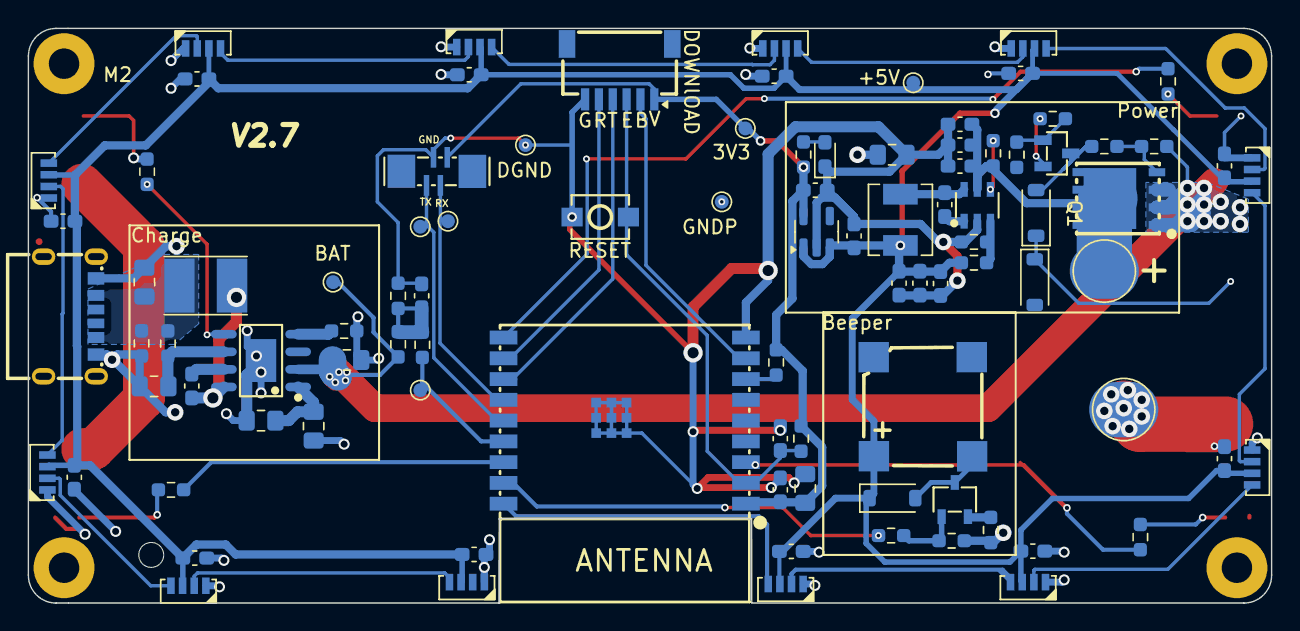
[picture p37: board bat_rf.kicad_pcb from below]

Board: 2 copper layers, 89.8 x 41.5 mm, 105 parts (95 on the bottom side), 57 nets.

Parts:
BT1: doubleBatCell; BAT-SMD_BH-18650-B1BA007
C1, C4: 2.2u; C_0603_1608Metric_Pad1.08x0.95mm_HandSolder
C2, C5, C6, C7, C11, C13, C14, C16, C17, C18, C27, C30, C31, C32, C33, C34, C35, C36, C37: 100n; C_0603_1608Metric_Pad1.08x0.95mm_HandSolder
C3, C8: 10u; C_0603_1608Metric_Pad1.08x0.95mm_HandSolder
C9, C15: 1u; C_0603_1608Metric_Pad1.08x0.95mm_HandSolder
C10, C26: 22u; C_0805_2012Metric_Pad1.18x1.45mm_HandSolder
C12, C28, C29, C40: 10u; C_0805_2012Metric_Pad1.18x1.45mm_HandSolder
D1, D5, D7: 1N4148W; D_SOD-123
D2: RED; LED_0603_1608Metric_Pad1.05x0.95mm_HandSolder
D3: G_LED; LED_0603_1608Metric_Pad1.05x0.95mm_HandSolder
D4: Y_LED; LED_0603_1608Metric_Pad1.05x0.95mm_HandSolder
D6: LED; LED_0603_1608Metric_Pad1.05x0.95mm_HandSolder
D13: B_LED; LED_0603_1608Metric_Pad1.05x0.95mm_HandSolder
FB1: FerriteBead_Small; C_0805_2012Metric_Pad1.18x1.45mm_HandSolder
H1, H2, H3, H4: MountingHole; MountingHole_2.2mm_M2_Pad
J1: USB_C_Receptacle_PowerOnly_6P; USB-C-SMD_HX-TYPE-C-6PIN
J2, J5: Conn_01x01_Pin; TestPoint_Pad_D4.0mm
J3: Conn_01x06; CONN-SMD_6P-P1.00_XYECONN_XY-SH1.0-6A61
L1: 10uH; L_Chilisin_BMRA00040420
L2: 2.2uH; L_Taiyo-Yuden_NR-40xx_HandSoldering
LED1, LED2, LED3, LED4, LED5, LED6, LED7, LED8, LED9, LED10, LED11, LED12: XL-4020RGBC-WS2812B; LED-SMD_4P-L4.0-W1.7_M4020-03003-RGB-862-001
P1: FPC_0.5MM_4P_Vertical_mounting_type_H2.0mm; FPC-SMD_4P-L7.5-W2.0-P0.50
Q1: IRFH7440TRPBF; DFN-8_L5.8-W4.9-P1.27-LS6.0-BL-1
Q5: AllPower__AP2300; SOT-23
R1: 0.5R; R_0603_1608Metric_Pad0.98x0.95mm_HandSolder
R2: 5k1; R_0603_1608Metric_Pad0.98x0.95mm_HandSolder
R3, R5, R13, R15: 3k; R_0603_1608Metric_Pad0.98x0.95mm_HandSolder
R4, R7, R8, R12, R21: 10k; R_0603_1608Metric_Pad0.98x0.95mm_HandSolder
R6, R19: 100R; R_0603_1608Metric_Pad0.98x0.95mm_HandSolder
R9: 7.5m; R_0603_1608Metric_Pad0.98x0.95mm_HandSolder
R10: 3m; R_0603_1608Metric_Pad0.98x0.95mm_HandSolder
R11: 22k; R_0603_1608Metric_Pad0.98x0.95mm_HandSolder
R14, R16, R20: 1k; R_0603_1608Metric_Pad0.98x0.95mm_HandSolder
R17: 500R; R_0603_1608Metric_Pad0.98x0.95mm_HandSolder
R18: 51k; R_0603_1608Metric_Pad0.98x0.95mm_HandSolder
R22: 160k; R_0603_1608Metric_Pad0.98x0.95mm_HandSolder
R23: 100k; R_0603_1608Metric_Pad0.98x0.95mm_HandSolder
SW1: 3*4*2.5MM_贴片4脚; SW-SMD_4P-L4.2-W3.3-P2.15-LS5.1
SW3: TS-1199A-B-B; SW-SMD_L4.0-W2.9-LS5.0
TP1, TP2, TP3, TP4, TP5, TP7, TP9, TP11: TestPoint; TestPoint_Pad_D1.0mm
U1: ESP32-C3-WROOM-02-N4; BULETM-SMD_18P-L20.0-W18.0-P1.50_ESP32-C3-WROOM
U2: IP2325_5M_WHJC; ESOP-8_L4.9-W3.9-P1.27-LS6.0-BL-EP3.1
U3: MT2492; SOT-23-6_L2.9-W1.6-P0.95-LS2.8-BL
U4: SS8050_C7420370; SOT-23-3_L2.9-W1.3-P1.90-LS2.4-BR
U5: MLT-8530-5V; BUZ-SMD_4P-L8.5-W8.5-TL
U7: XC6220B331MR; SOT-23-5

Connections:
+3V3: C12.1, C13.1, C15.1, J3.1, P1.4, R4.2, R12.2, R16.1, TP2.1, U1.1 (3V3), U7.5 (VOUT)
+5V: C4.1, C5.2, C6.2, C7.1, C8.1, C9.1, C11.2, C14.2, C17.2, C30.2, C31.2, C32.2, C33.2, C34.2, C35.2, C36.2, D5.1 (K), L1.2, LED1.3 (VDD), LED2.3 (VDD), LED3.3 (VDD), LED4.3 (VDD), LED5.3 (VDD), LED6.3 (VDD), LED7.3 (VDD), LED8.3 (VDD), LED9.3 (VDD), LED10.3 (VDD), LED11.3 (VDD), LED12.3 (VDD), R22.2, TP7.1, U5.1 (+), U7.1 (VIN), U7.3 (CE)
+BATT: BT1.1 (+), C40.1, Q1.1 (S), Q1.2 (S), Q1.3 (S), R8.2, R9.2, TP11.1, U2.2 (VOUT)
/BAT_FB: R14.1, TP5.1, U1.15 (IO3)
/BEEP: R6.1, U1.17 (IO1)
/BLUE: R13.1, U1.10 (IO10)
/EN: C16.1, J3.3, R12.1, SW3.2, U1.2 (EN)
/ESP_RX: P1.3, TP3.1, U1.13 (IO18)
/ESP_TX: P1.1, TP4.1, U1.14 (IO19)
/GREEN: R5.1, U1.3 (IO4)
/IO9: J3.2, U1.8 (IO9)
/K1: D7.2 (A), R19.1, U4.3 (C)
/KEY: D1.2 (A), U1.6 (IO7)
/POWER_EN: R20.1, U1.5 (IO6)
/RGB: LED7.4 (DI), U1.18 (IO0)
/RXD: J3.5, U1.11 (RXD)
/TXD: J3.4, U1.12 (TXD)
/YELLOW: R15.1, U1.16 (IO2)
GNDD: C1.2, C2.2, C3.2, C4.2, C7.2, C8.2, C9.2, C12.2, C13.2, C15.2, C16.2, C37.2, D6.1 (K), FB1.2, J3.6, P1.2, R10.1, R11.2, SW3.1, TP1.1, U1.9 (GND), U1.19 (EP), U3.2 (GND), U7.2 (GND)
GNDPWR: BT1.4 (-), C5.1, C6.1, C10.2, C11.1, C14.1, C17.1, C26.2, C28.2, C29.2, C30.1, C31.1, C32.1, C33.1, C34.1, C35.1, C36.1, C40.2, D2.1 (K), D3.1 (K), D4.1 (K), D13.1 (K), FB1.1, J1.A12 (GND), J1.B12 (GND), J5.1, LED1.1 (VSS), LED2.1 (VSS), LED3.1 (VSS), LED4.1 (VSS), LED5.1 (VSS), LED6.1 (VSS), LED7.1 (VSS), LED8.1 (VSS), LED9.1 (VSS), LED10.1 (VSS), LED11.1 (VSS), LED12.1 (VSS), R2.1, R7.1, R17.1, R18.1, R21.2, SW1.4, TP9.1, U2.9 (GND), U4.2 (E)
unnamed: BT1.2 (-), BT1.3 (+)
unnamed: C28.1, J1.A9 (VBUS), J1.B9 (VBUS), L2.1, R1.1, R2.2
unnamed: C37.1, R9.1, R10.2, R14.2
unnamed: D1.1 (K), D7.1 (K), SW1.1
unnamed: D2.2 (A), R3.1
unnamed: D3.2 (A), R5.2
unnamed: D4.2 (A), R15.2
unnamed: D5.2 (A), Q5.3 (D), U5.2 (-)
unnamed: D6.2 (A), R16.2
unnamed: D13.2 (A), R13.2
unnamed: LED1.4 (DI), LED2.2 (DO)
unnamed: LED1.2 (DO), LED10.4 (DI)
unnamed: LED2.4 (DI), LED3.2 (DO)
unnamed: LED3.4 (DI), LED4.2 (DO)
unnamed: LED4.4 (DI), LED5.2 (DO)
unnamed: LED5.4 (DI), LED6.2 (DO)
unnamed: LED6.4 (DI), LED7.2 (DO)
unnamed: LED8.4 (DI), LED9.2 (DO)
unnamed: LED9.4 (DI), LED10.2 (DO)
unnamed: LED11.4 (DI), LED12.2 (DO)
unnamed: LED8.2 (DO), LED12.4 (DI)
unnamed: Q1.4 (G), R8.1, R19.2
unnamed: Q5.1 (G), R6.2, R7.2
unnamed: Q5.2 (S), R17.2
unnamed: R4.1, U1.7 (IO8)
unnamed: C27.1, U2.7 (BST)
unnamed: R3.2, U2.5 (LED)
unnamed: C27.2, L2.2, U2.8 (LX)
unnamed: R18.2, U2.4 (NTC)
unnamed: C29.1, R1.2, U2.6 (VIN)
unnamed: C10.1, C26.1, U2.1 (VSYS)
unnamed: C18.1, U3.1 (BS)
unnamed: R23.1, U3.4 (EN)
unnamed: R11.1, R22.1, U3.3 (FB)
unnamed: C18.2, L1.1, U3.6 (SW)
unnamed: R20.2, R21.1, U4.1 (B)
VCC: C1.1, C2.1, C3.1, J2.1, Q1.5 (D), Q1.6 (D), Q1.7 (D), Q1.8 (D), Q1.9 (D), R23.2, U3.5 (IN)
