podwan/biWheeler/hardware/encoder/encoder.kicad_pcb

## KiCad design hardware/encoder/encoder.kicad_pcb (2024-07-28)

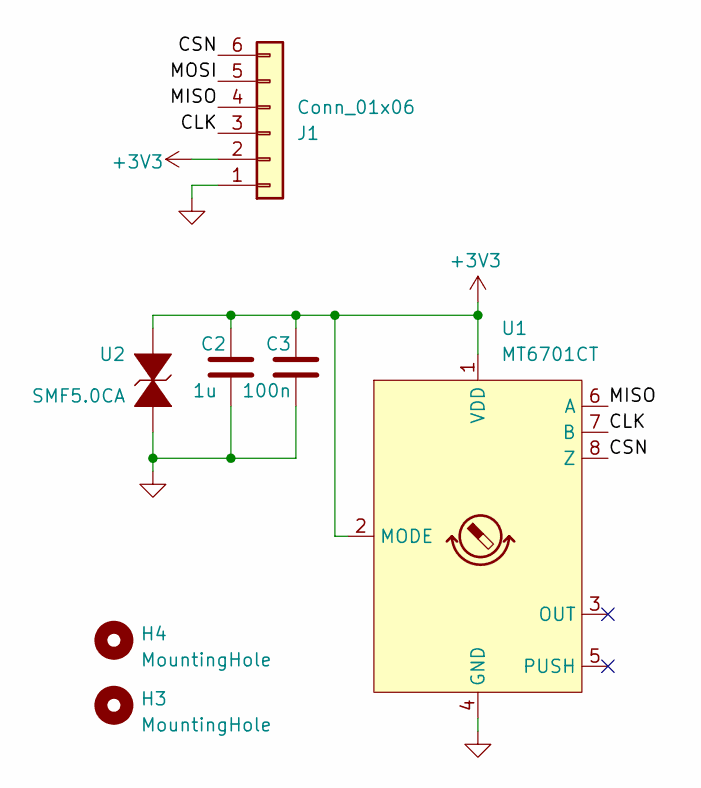
[picture p38: schematic encoder.kicad_sch]

Parts:
C2: 1u; C_0603_1608Metric_Pad1.08x0.95mm_HandSolder
C3: 100n; C_0603_1608Metric_Pad1.08x0.95mm_HandSolder
H3, H4: MountingHole; MountingHole_2.2mm_M2_Pad_Via
J1: Conn_01x06; FPC-SMD_6P-P0.50_HDGC_0.5K-A-6PB
U1: MT6701CT; SO-8_3.9x4.9mm_P1.27mm
U2: SMF5.0CA

Connections:
+3V3: C2.1, C3.1, J1.2, U1.1 (VDD), U1.2 (MODE), U2.1
/CLK: J1.3, U1.7 (B)
/CSN: J1.6, U1.8 (Z)
/MISO: J1.4, U1.6 (A)
/MOSI: J1.5
GND: C2.2, C3.2, J1.1, U1.4 (GND), U2.2

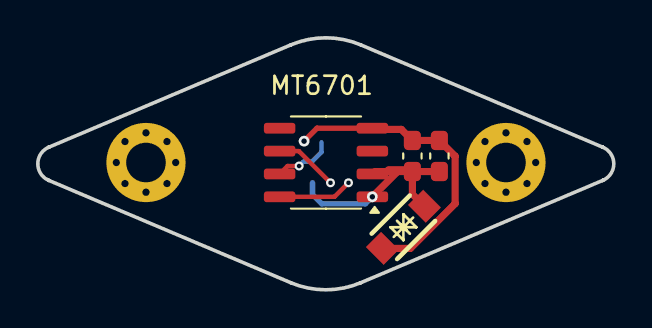
[picture p39: board encoder.kicad_pcb from above]

Board: 2 copper layers, 32.0 x 14.0 mm, 7 parts (1 on the bottom side), 5 nets.
