podwan/biWheeler/hardware/encoder/doc/AS5600资料/as5600/as5600/Inc/main.h

#define IIC_SCL_Pin GPIO_PIN_9
#define IIC_SCL_GPIO_Port GPIOA
#define IIC_SDA_Pin GPIO_PIN_10
#define IIC_SDA_GPIO_Port GPIOA
