podwan/biWheeler/hardware/encoder/doc/AS5600资料/as5600/as5600/Src/main.c

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

/* Includes ------------------------------------------------------------------*/
#include "main.h"

/* USER CODE BEGIN Includes */
#include "as5600.h"
/* USER CODE END Includes */

UART_HandleTypeDef huart1;
DMA_HandleTypeDef hdma_usart1_rx;

void SystemClock_Config(void);
static void MX_GPIO_Init(void);
static void MX_DMA_Init(void);
static void MX_USART1_UART_Init(void);
/* USER CODE BEGIN PFP */
void Uart_RxOvertimeEnable(void);
uint8_t aRxBuffer[2]={0};

uint8_t noMagnetStr[] = "Error: magnet not detected";
/* USER CODE END PFP */

/* USER CODE BEGIN 0 */
#ifdef __GNUC__
  /* With GCC/RAISONANCE, small printf (option LD Linker->Libraries->Small printf
     set to 'Yes') calls __io_putchar() */
  #define PUTCHAR_PROTOTYPE int __io_putchar(int ch)
#else
  #define PUTCHAR_PROTOTYPE int fputc(int ch, FILE *f)
#endif /* __GNUC__ */
/* USER CODE END 0 */

/**
  * @brief  The application entry point.
  * @retval int
  */
int main(void)
{
  /* MCU Configuration--------------------------------------------------------*/

  /* Reset of all peripherals, Initializes the Flash interface and the Systick. */
  HAL_Init();

  /* Configure the system clock */
  SystemClock_Config();

  /* Initialize all configured peripherals */
  MX_GPIO_Init();
  MX_DMA_Init();
  MX_USART1_UART_Init();
  /* USER CODE BEGIN 2 */
  Uart_RxOvertimeEnable();
	/*采用中断接收数据，模拟接收*/
  HAL_UART_Receive_IT(&huart1, (uint8_t *)aRxBuffer, 2);
  /* USER CODE END 2 */

  /* Infinite loop */
  /* USER CODE BEGIN WHILE */
  while (1)
  {
    /* USER CODE END WHILE */

    /* USER CODE BEGIN 3 */
//   while(READ_BIT(huart1.Instance->ISR,USART_ISR_RTOF))
//	 { 
//		char incomingByteBuffer[2];
//    char incomingByte;
//    
//    incomingByteBuffer[0] = aRxBuffer[0];
//    incomingByteBuffer[1] = aRxBuffer[1];
//     
//		/*清除rtof标志*/
//		 SET_BIT(huart1.Instance->ICR,USART_ICR_RTOCF);
//		 
//		if ((incomingByteBuffer[0] >= 48) && (incomingByteBuffer[0] < 60))
//    {
//      incomingByte = incomingByteBuffer[0] - 48;
//    }
//    
//    if ((incomingByteBuffer[1] >= 48) && (incomingByteBuffer[1] < 60))
//    {
//      incomingByte *=10;
//      incomingByte += incomingByteBuffer[1] - 48;
//    }
//		printf("incomingByte is %d\r\n",incomingByte);
//	  // PrintMenu(); 
//		
//		 HAL_UART_Abort_IT(&huart1);
//		 aRxBuffer[0]=0;
//		 aRxBuffer[1]=0;
//		 HAL_UART_Receive_IT(&huart1, (uint8_t *)aRxBuffer, 2);
//		// HAL_Delay(1000);
//		
//		
   Programe_Run();
	 HAL_Delay(500);

   }
    //printf("incomingByte is %d\r\n",incomingByte);
  /* USER CODE END 3 */
}

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
/* USER CODE BEGIN 4 */

PUTCHAR_PROTOTYPE
{
  /* Place your implementation of fputc here ??*/
  /* e.g. write a character to the EVAL_COM1 and Loop until the end of transmission */
  HAL_UART_Transmit(&huart1, (uint8_t *)&ch, 1, 0xFFFF);
  return ch;
}


void Uart_RxOvertimeEnable(void)
{
	/*使能接收超时功能*/
	SET_BIT(huart1.Instance->CR2,USART_CR2_RTOEN);
	/*使能超时接收中断*/
	//SET_BIT(huart1.Instance->CR1,USART_CR1_RTOIE);
	/*向RTOR寄存器填入需要超时的长度，单位为一个波特时长,3.5个字节*11波特长度 = 39  */
	WRITE_REG(huart1.Instance->RTOR,39);  
}

/* USER CODE END 4 */
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
