podwan/biWheeler/(notices)

Notices in the files:
hardware/encoder/doc/AS5600资料/as5600/as5600/Inc/main.h:
COPYRIGHT(c) 2018 STMicroelectronics
(C) COPYRIGHT STMicroelectronics *****END OF FILE
